hibagus/64pointFFTProcessor/Verification/UVM/sim/README

LAB 3 - Universal Verification Methodology

make all : To run the given uvm_test, which generates 100 input sequences randomly and applies them to the DUT. This does not fire the GUI.

make gui : Fires the same test as above, however alongside the GUI

make clean : Removes the work directory and the transcript
