hibagus/64pointFFTProcessor/Report/EE382M_Verification_for_Digital_System/EE382M_Verification_Project_Report.pdf

Bagus Hanindhito (bh29293), Tosin Jemilehin (tej474), Ashen Ekanayake (ese396) The University of Texas at Austin

MAY 2020

# Verification of 64 Point FFT/IFFT Processor

EE 382M-11 Verification of Digital Systems

- Introduction
- Formal Verification
- Universal Verification Methodology
- Logical Equivalence Checking
- Conclusion

### Agenda

# Introduction

### Basic Operation

- The circuit decomposes 64-point FFT/IFFT into two-dimensional 8-point FFT/IFFT.
– A s + 8t = σl=0
7 W64
sl σm=0
7 | B(l + 8m)W8
sm | W8

lt
– W8
sm and W8

lt are 8-point twiddle-factors (complex constant) – W64
sl is 64-point twiddle-factors (complex constant)
- No true multiplier; Multiplication is implemented as shift-and-add.

### Data Format

- The circuit uses Q4.12 Signed Fixed-Point format for both real data and imaginary data to form 32-bit complex data. – Largest value is 7.9997558593750 (0b0111111111111111)
– Smallest value is -8.0000000000000 (0b1000000000000000) – Resolution is 0.0002441406250 (0b0000000000000001)

Complex Data Set (32-bit)

31...16 Real Data (16-bit) 15...0 Imaginary Data (16-bit)

### Block Diagram

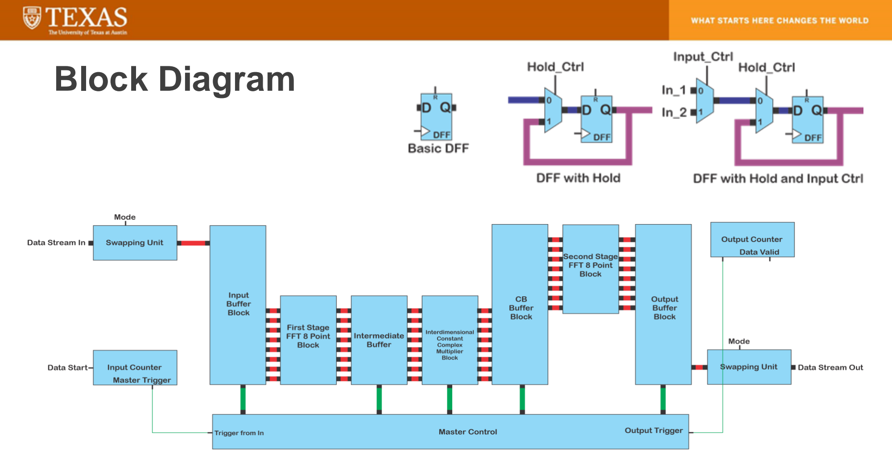
[picture p5: page 6]

### Circuit Behavior

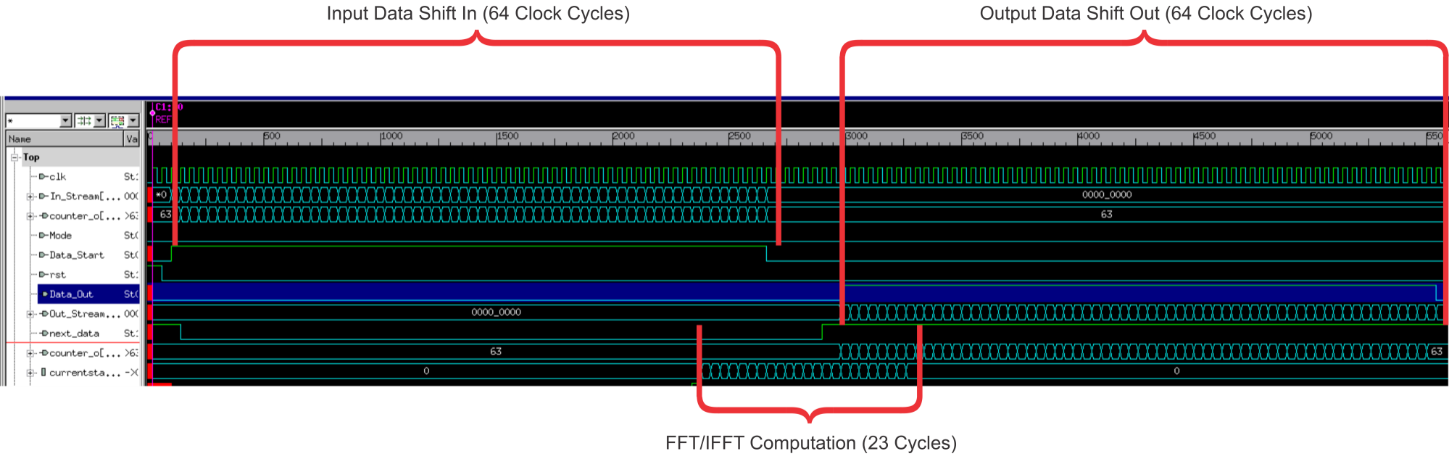
[picture p6: figure]

- Single FFT/IFFT operation can be completed in 135 Cycles

### Verification Plan

- Formal Verification
– To verify the Master Control block (RTL-Level)
- Universal Verification Methodology (UVM) – To verify full-circuit functionality (RTL-Level)
- Logical Equivalence Checking (LEC)
– To verify synthesized netlist against RTL model
– To verify implementation against the generated netlist

# Formal Verification

### Overview

- Formal Verification using Cadence JasperGold.
- Verification is done for Master Control block.
– The heart of the circuit.
– Control the dataflow and operation throughout the circuit.
– Need to be verified extensively.
- Properties are written based on the specification of the circuits.

### Assumption

- Master control is triggered by Input Counter when the 56th input data enters the Input Buffer.
– Mastertrig signal goes high at least one clock cycle.
- Master control consists of 23 states
– 23 clock cycles to perform FFT/IFFT computation – No interruption is possible after triggered.
– Full cycle starts at IDLE state, end at IDLE state. – Cannot be triggered before the full cycle is ended.

### Input Data Set

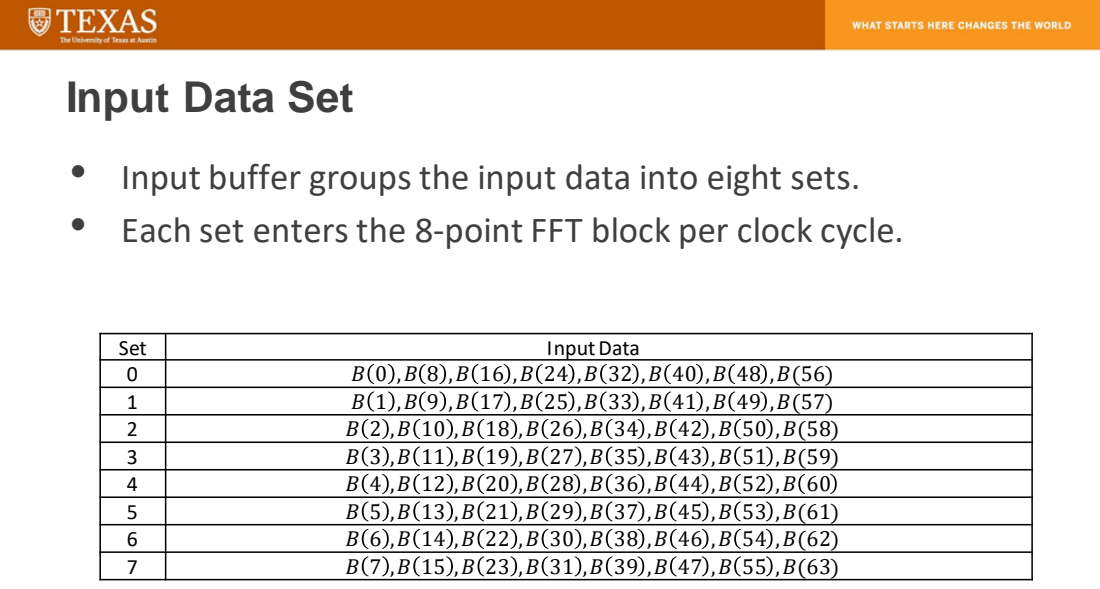
[picture p7: page 12]

• Input buffer groups the input data into eight sets.
• Each set enters the 8-point FFT block per clock cycle.

Set | Input Data
0 | B 0 ,B 8 ,B 16 ,B 24 ,B 32 ,B 40 ,B 48 ,B(56)
1 | B 1 ,B 9 ,B 17 ,B 25 ,B 33 ,B 41 ,B 49 ,B(57)
2 | B 2 ,B 10 ,B 18 ,B 26 ,B 34 ,B 42 ,B 50 ,B(58)
3 | B 3 ,B 11 ,B 19 ,B 27 ,B 35 ,B 43 ,B 51 ,B(59)
4 | B 4 ,B 12 ,B 20 ,B 28 ,B 36 ,B 44 ,B 52 ,B 60
5 | B 5 ,B 13 ,B 21 ,B 29 ,B 37 ,B 45 ,B 53 ,B(61)
6 | B 6 ,B 14 ,B 22 ,B 30 ,B 38 ,B 46 ,B 54 ,B(62)
7 | B 7 ,B 15 ,B 23 ,B 31 ,B 39 ,B 47 ,B 55 ,B(63)

### Complex Constant Multiplier Scheduling

- This specification governs how the master control block behaves. (Red = Multi-Cycle Multiplication)
SET | DATA0 | DATA1 | DATA2 | DATA3 | DATA4 | DATA5 | DATA6 | DATA7
CONST | TYPE | CONST | TYPE | CONST | TYPE | CONST | TYPE | CONST | TYPE | CONST | TYPE | CONST | TYPE | CONST | TYPE
SET 0 | BYPASS | 1 | BYPASS | 1 | BYPASS | 1 | BYPASS | 1 | BYPASS | 1 | BYPASS | 1 | BYPASS | 1 | BYPASS | 1
SET 1 | BYPASS | 1 | 1 | 1 | 2 | 1 | 3 | 1 | 4 | 1 | 5 | 1 | 6 | 1 | 7 | 1
SET 2 | BYPASS | 1 | 2 | 1 | 4 | 1 | 6 | 1 | 8 | 1 | HOLD | HL | HOLD | | HOLD | HL
| HOLD | 1 | HOLD | HL | HOLD | HL | HOLD | HL | HOLD | HL | 6 | 5 | 4 | 5 | 2 | 5
SET 3 | BYPASS | 1 | 3 | 1 | 6 | 1 | 7 | 5 | 4 | 5 | 1 | 5 | 2 | 7 | 5 | 7
SET 4 | BYPASS | 1 | 4 | 1 | 8 | 1 | HOLD | HL | BYPASS | 5 | HOLD | HL | HOLD | HL | HOLD | HL
| HOLD | HL | HOLD | HL | HOLD | HL | 4 | 5 | HOLD | HL | HOLD | HL | HOLD | HL | HOLD | HL
| HOLD | HL | HOLD | HL | HOLD | HL | HOLD | HL | HOLD | HL | 4 | 7 | 8 | 7 | HOLD | HL
| HOLD | HL | HOLD | HL | HOLD | HL | HOLD | HL | HOLD | HL | HOLD | HL | HOLD | HL | 4 | 3
SET 5 | BYPASS | 1 | 5 | 1 | 6 | 5 | 1 | 5 | 4 | 7 | 7 | 3 | 2 | 3 | 3 | 2
SET 6 | BYPASS | 1 | 6 | 1 | 4 | 5 | 2 | 7 | 8 | 7 | HOLD | HL | HOLD | HL | HOLD | HL
| HOLD | HL | HOLD | HL | HOLD | HL | HOLD | HL | HOLD | HL | 2 | 3 | 4 | 2 | 6 | 6
SET 7 | BYPASS | 1 | 7 | 1 | 2 | 5 | 5 | 7 | 4 | 3 | 3 | 2 | 6 | 6 | 1 | 4

### Input Buffer Control Signal

- hold_all_in

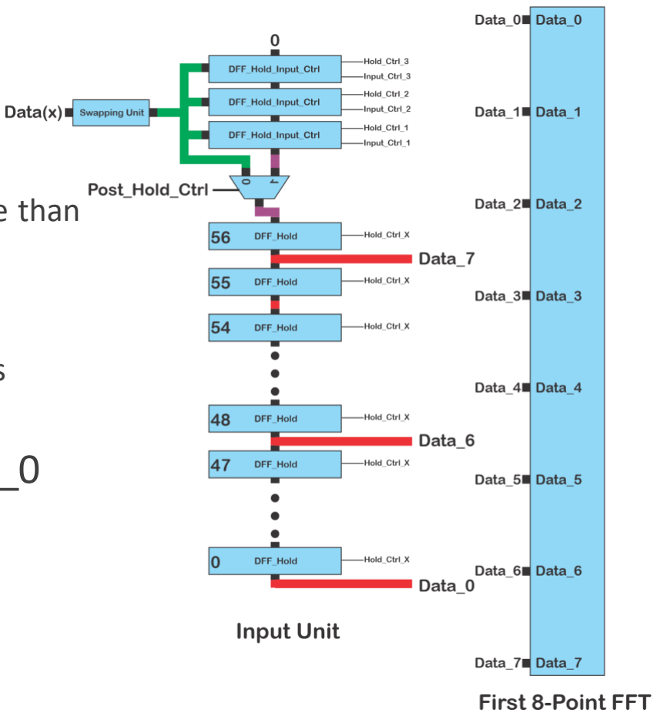
[picture p8: figure]

– Stall input circuit when multiplier needs more than 1 cycle
- hold_buf_2, hold_buf_1, hold_buf_0

– Stall additional buffers when multiplier needs more than 1 cycle.
- in_ctrl_buf_2, in_ctrl_buf_1, in_ctrl_buf_0

– Select the input of additional buffers.
- pos_hold_ctrl

– Select the input of main buffer segment.

### Input Buffer Control Signal Assertion

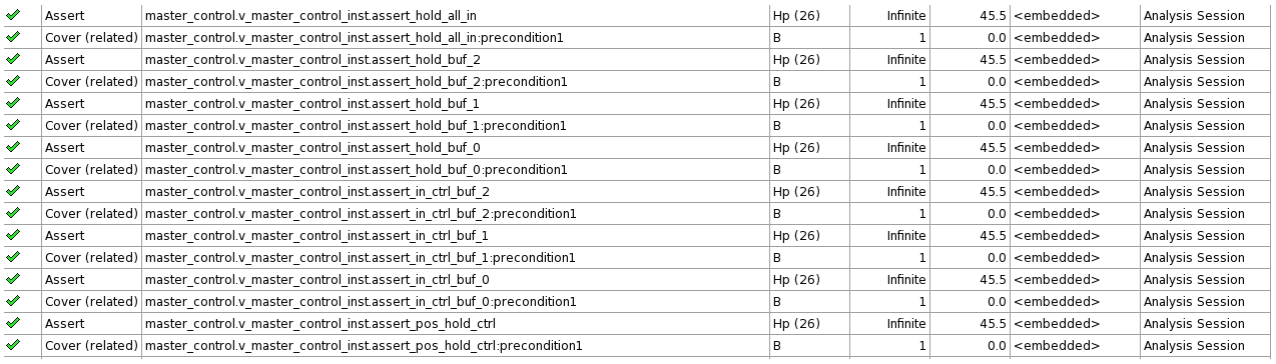
[picture p9: figure]

### Complex Constant Multiplier Unit

- Eight complex constant multiplier blocks, one for each type.
Type | Input Operand | Pre-Processing | Constant Operand | Result | Post Processing
1 | A + jB | NONE A + jB | C + jD | AC − BD + j(AD + BC) | NONE AC − BD + j(AD + BC)
2 | A + jB | IM_INVERT A − jB | C + jD | AC + BD + j(AD − BC) | IM_INVERT AC + BD + j(−AD + BC)
3 | A + jB | RE_INVERT −A + jB | C + jD | −AC − BD + j(−AD + BC) | IM_INVERT −AC − BD + j(AD − BC)
4 | A + jB | RE_INVERT IM_INVERT −A − jB | C + jD | −AC + BD + j(−AD − BC) | NONE −AC + BD + j(−AD − BC)
5 | A + jB | RE-IM SWAP B + jA | C + jD | −AD + BC + j(AC + BD) | RE_INVERT AD − BC + j(AC + BD)
6 | A + jB | RE-IM SWAP IM_INVERT B − jA | C + jD | AD + BC + j(−AC + BD) | NONE AD + BC + j(−AC + BD)
7 | A + jB | RE-IM SWAP RE_INVERT −B + jA | C + jD | −AD − BC + j(AC − BD) | NONE −AD − BC + j(AC − BD)
8 | A + jB | RE-IM SWAP RE_INVERT IM_INVERT −B − jA | C + jD | AD − BC + j(−AC − BD) | RE_INVERT −AD + BC + j(−AC − BD)

### Complex Constant Multiplier Unit (cont’d)

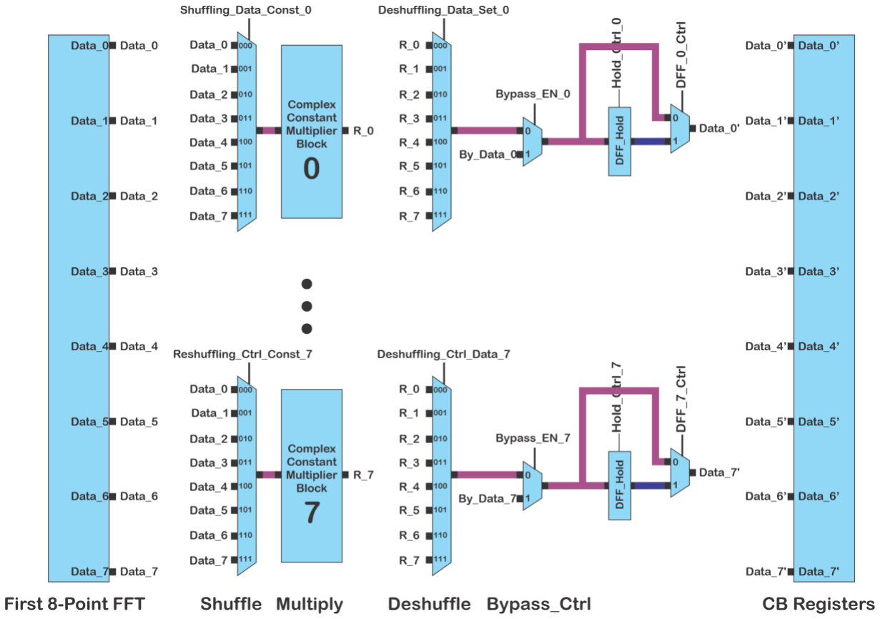
[picture p10: figure]

### Complex Const. Mult.: Shuffle Unit

- Shuf_Ctrl_0 through Shuf_Ctrl_7

– Select which set of data goes which constant multiplier.

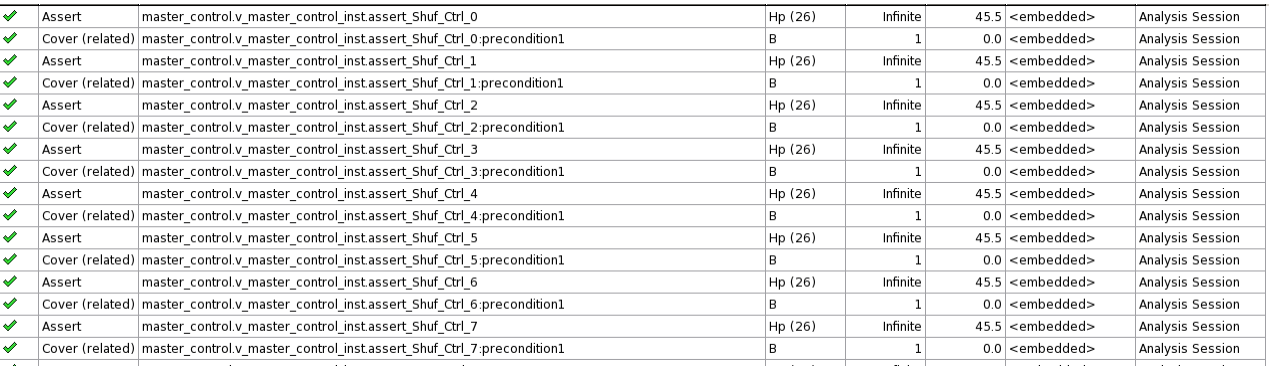
[picture p11: figure]

### Complex Const. Mult.: Multiplier Unit

- Type_Sel_0 through Type_Sel_7

– Select the type of operation that each multiplier does.

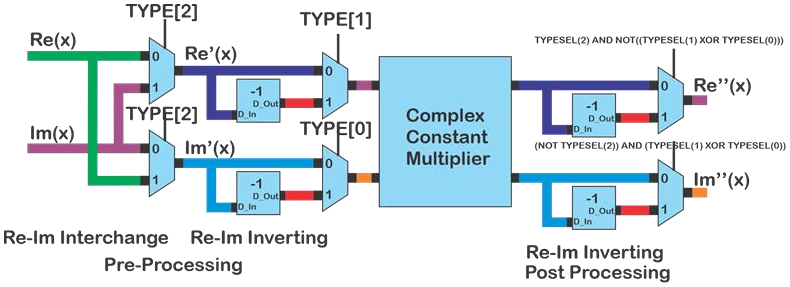
[picture p12: figure]

### Complex Const. Mult.: Multiplier Unit Assertion

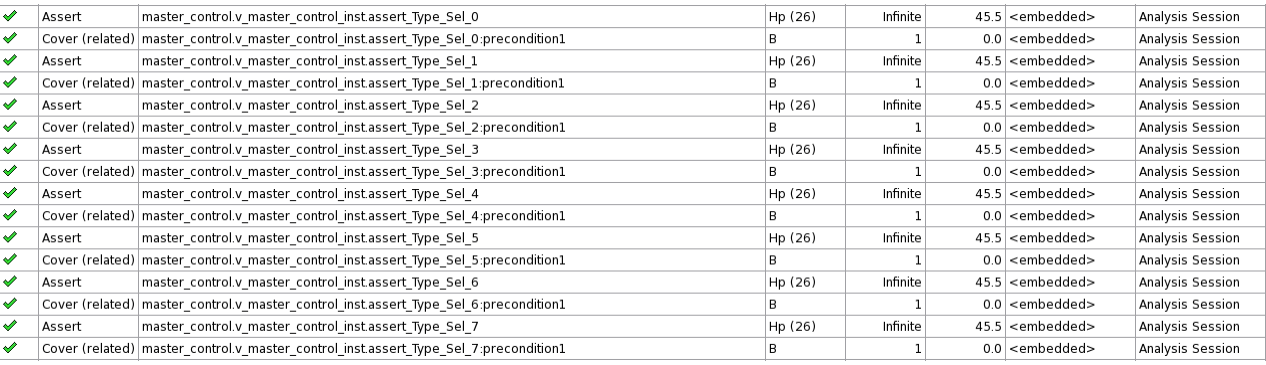
[picture p13: figure]

### Complex Const. Mult.: Bypass Unit

- Bypass_Sel_0 through Bypass_Sel_7

– Select whether a multiplication is performed or not for each multiplication block. Bypass means no multiplication (only swapping or sign inverting the real and imaginary parts).

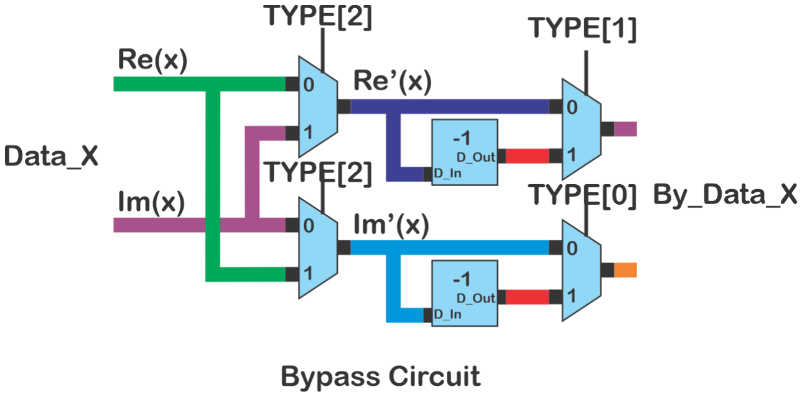
[picture p14: figure]

### Complex Const. Mult.: Bypass Unit Assertion

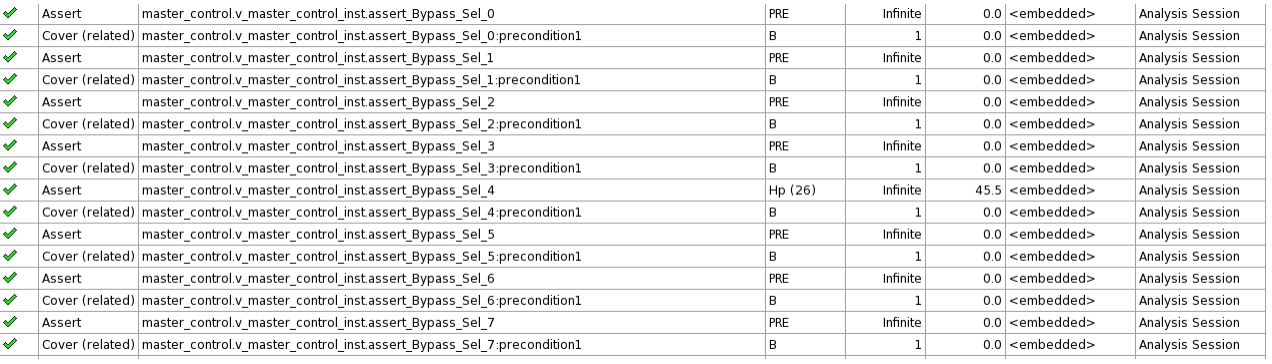
[picture p15: figure]

### Complex Const. Mult.: Deshuffle Unit

- DeShuf_Ctrl_0 through DeShuf_Ctrl_7

– Select return path of the dataset after being multiplied.

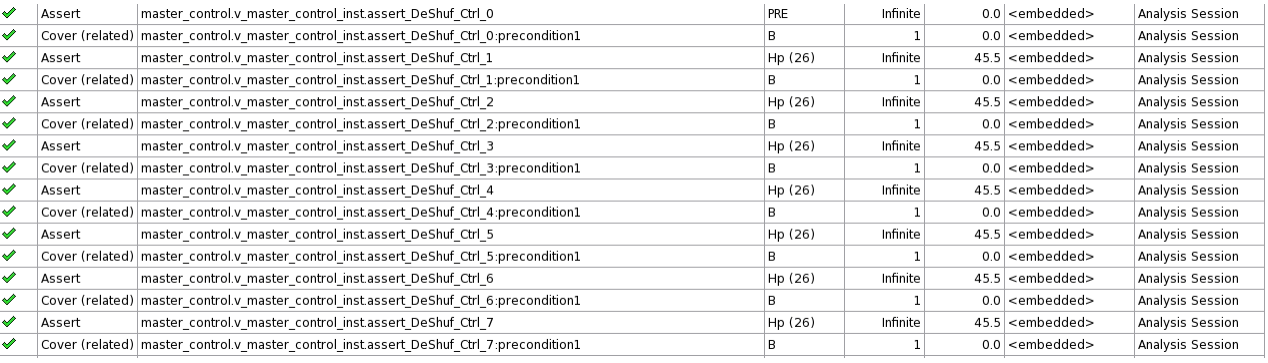
[picture p16: figure]

### Complex Const. Mult.: Datapath Unit

- Bypass_EN_0 through Bypass_EN_7

– Select whether to use dataset from multiplier unit or from bypass unit.
- Hold_Ctrl_0 through Hold_Ctrl_7

– Select whether to stall the datapath due to multicycle multiplication.
- DFF_Ctrl_0 through DFF_Ctrl_7

– Select whether to use next data or delayed data.

### Complex Const. Mult.: Datapath Unit (Assertion)

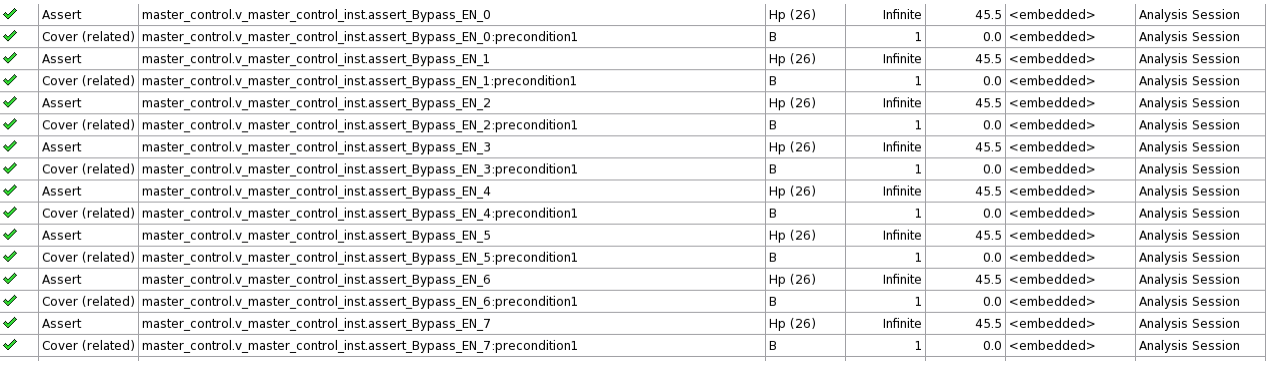
[picture p17: figure]

### Complex Const. Mult.: Datapath Unit (Assertion)

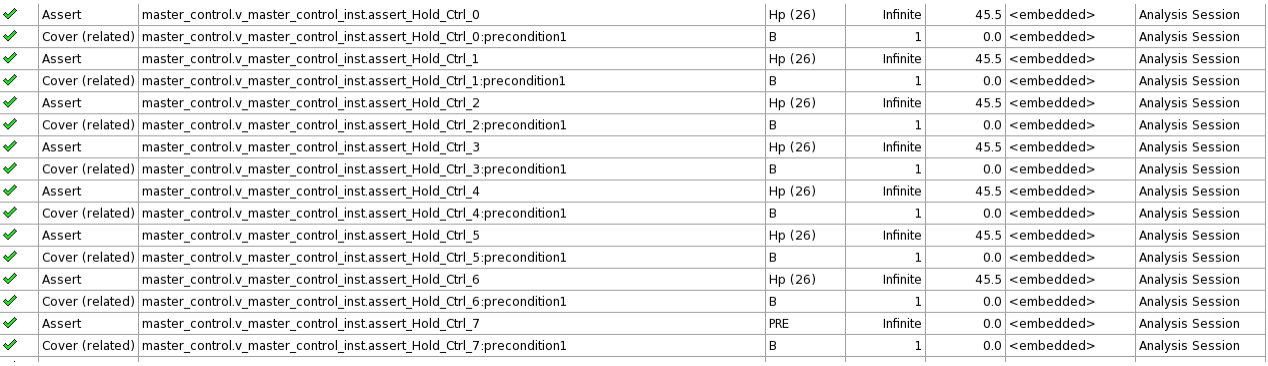
[picture p18: figure]

### Complex Const. Mult.: Datapath Unit (Assertion)

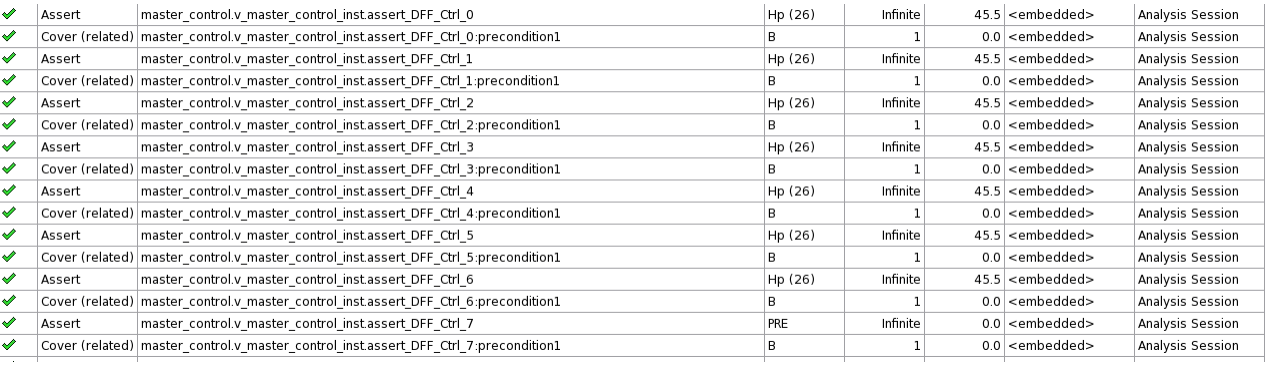
[picture p19: figure]

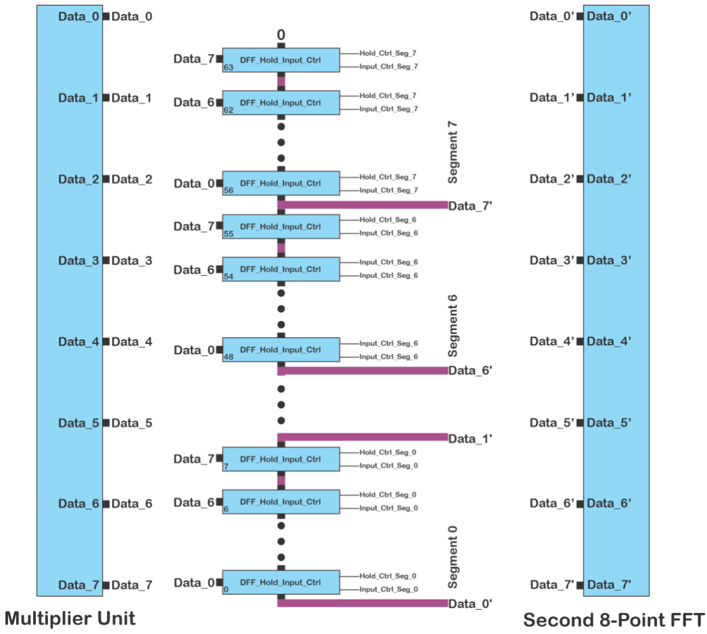
[picture p20: figure]

### Compute Buffer (CB)

- Rearrange Dataset for second stage of 8-point FFT.
- hold_seg_0 through hold_seg_7

– To stall each segment of the buffer
- input_ctrl_all_cb

– To select which data to buffer.

### Compute Buffer (CB) (Assertion)

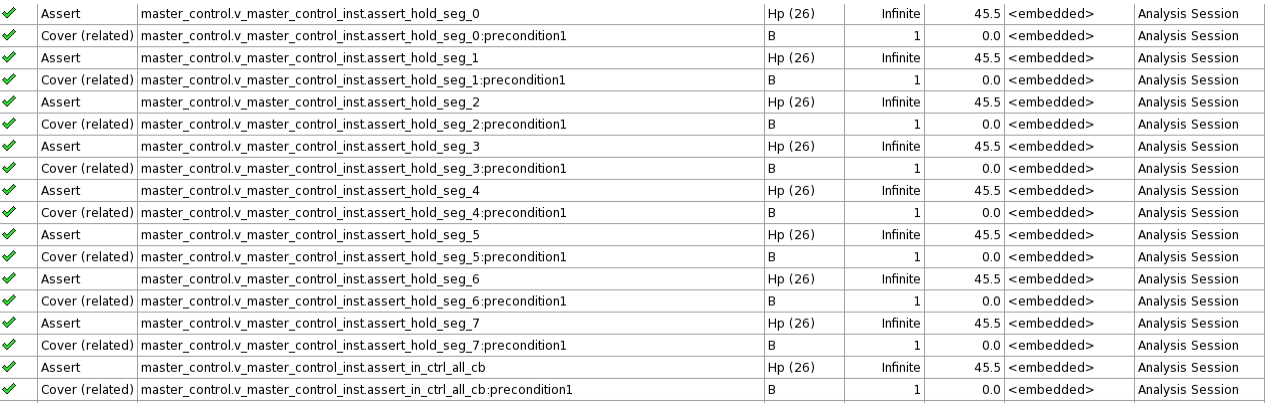
[picture p21: figure]

### Output Buffer

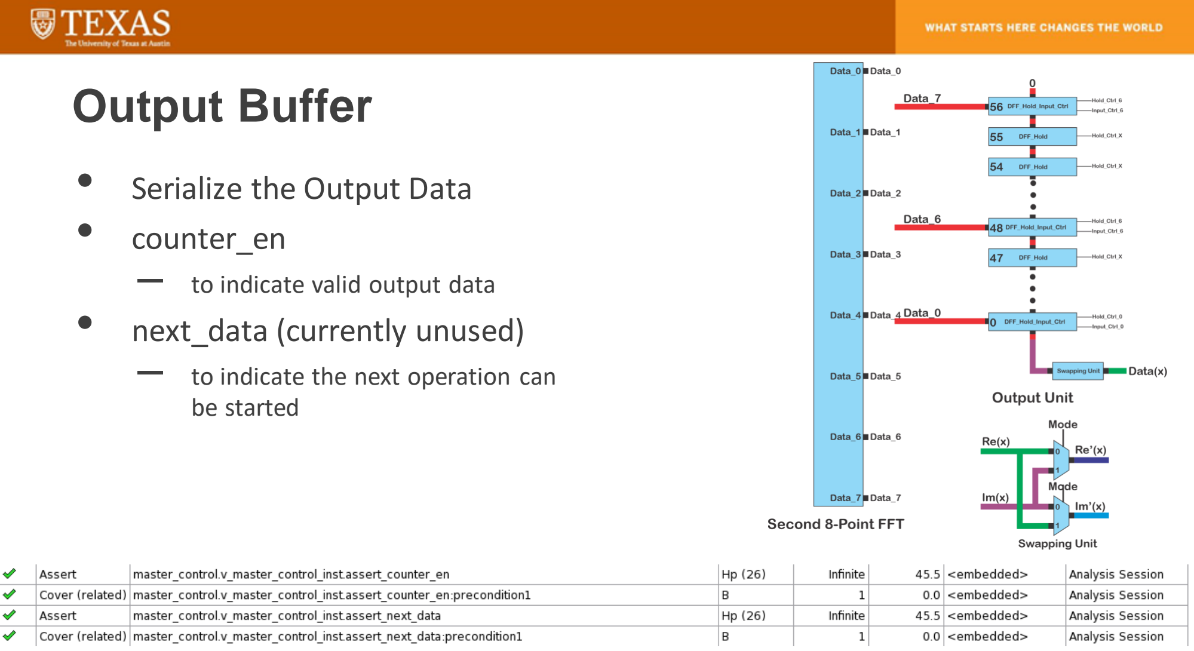
[picture p22: page 30]

- Serialize the Output Data
- counter_en

– to indicate valid output data
- next_data (currently unused)

– to indicate the next operation can be started

# Universal Verification Methodology (UVM)

- Step 1: Understanding the Interface

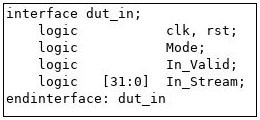
[picture p23: figure]

- Step 2: Create a dummy (DUT) module to setup the UVM environment

Mimic the basic behavior without worrying about the exact functionality

(Using the same input output interfaces)

### UVM Verification Steps

- Step 3: Modify the Scoreboard
- Difficult
– 16-bit Fixed Point
– No SV Support

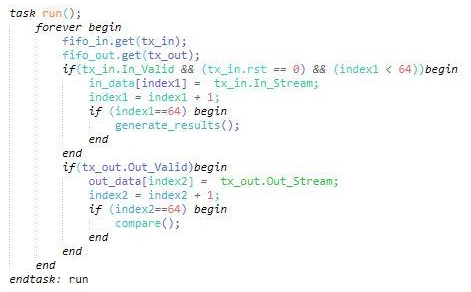
[picture p24: figure]

- Solution
– Connect FFT and
IFFT together as
the DUT
- Alternative Solution
– DPI-C
- Step 4: Write a Perfect FFT

### UVM Verification Steps (cont’d)

FFT | IFFT

Time Domain
Data In

Time Domain
Data Out

Frequency
Domain Data

Theoretically,
Time Domain Data In = Time Domain Data Out

However there might be small errors due to rounding off in fixed point arithmetic

### UVM Verification Steps (cont’d)

- Step 5: Generating the sequences

– Reset sequences (created a new sequence class)
– Usual input data sequence with necessary constraints

(- 0.10009765625 < Data < 0.10009765625)

– Generate enough sequences to get an output

### UVM Verification Steps (cont’d)

- Step 6: Simulating Using “ModelSim”

### UVM Verification Steps (cont’d)

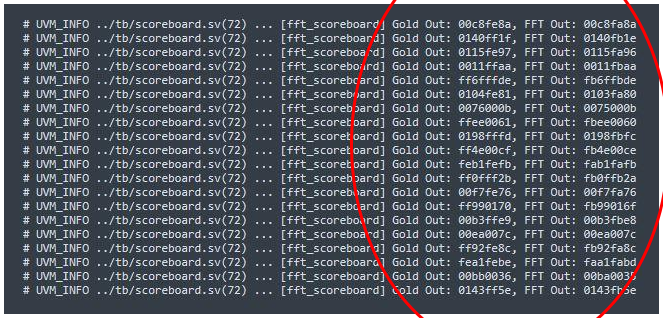
[picture p25: figure]

# Logical Equivalence Checking

Motivation
- To ensure logical equivalence doesn't break along chip design process
- To ensure design intent is retained as design move into real life implementation

### Logical Equivalence Checking

### Stages considered

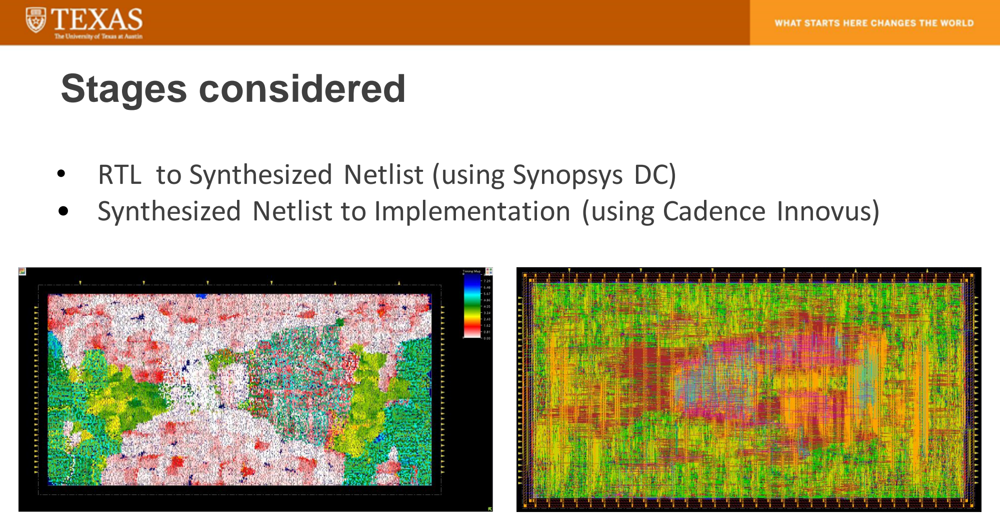
[picture p26: page 39]

- RTL to Synthesized Netlist (using Synopsys DC)
- Synthesized Netlist to Implementation (using Cadence Innovus)

- Setup
– Identifying keypoints/cuts
- Mapping
– Mapping keypoints
- Comparison

First stage
- RTL ---> Synthesized Netlist

### LEC Workflow

- Setup
– Golden -> RTL
– Revised -> Generated Netlist
- Assumption
– Sequential constant set to 0 – Sequential merge to reduce unreachable states

### RTL to Synthesized Netlist

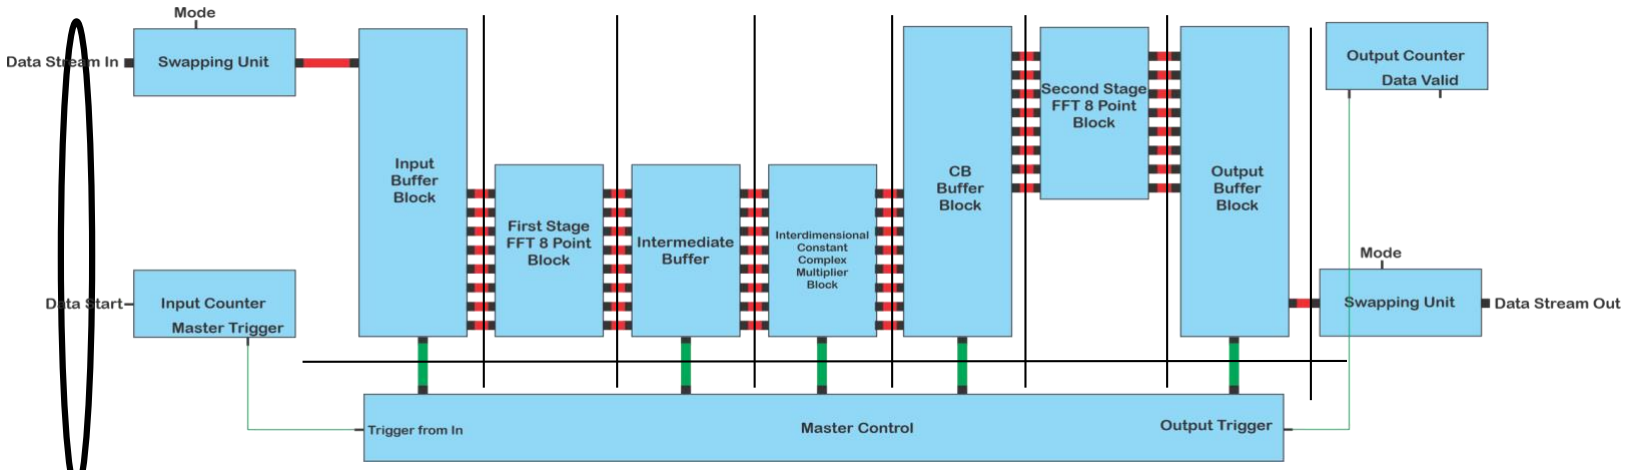
[picture p27: figure]

### RTL to Synthesized Netlist(Mapping)

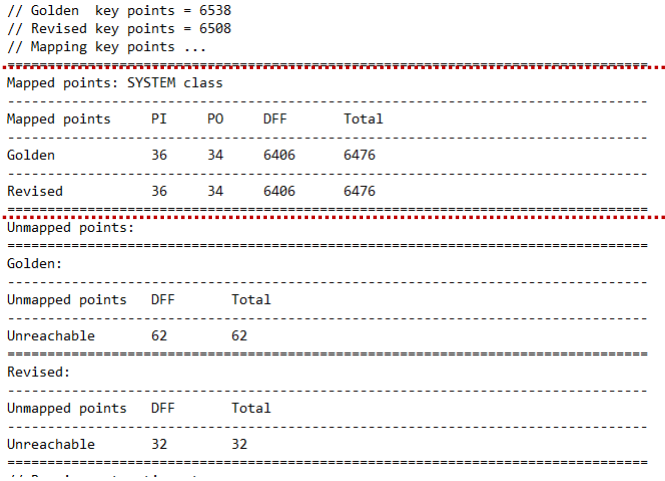
[picture p28: figure]

### RTL to Synthesized Netlist(Mapping)

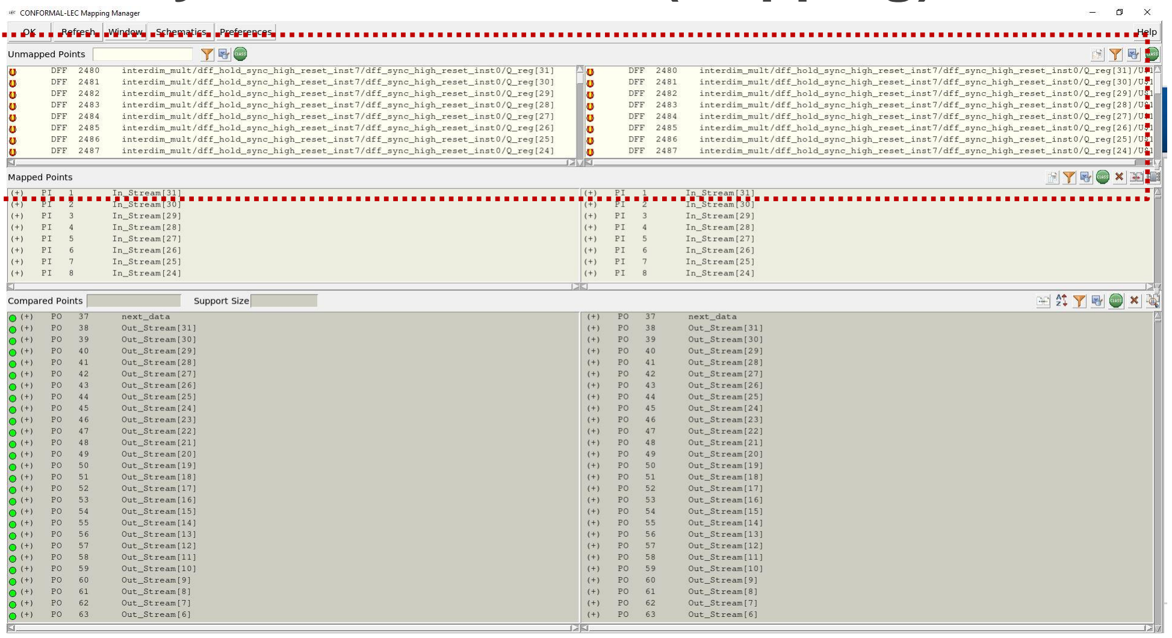
[picture p29: figure]

Mapping manager

### RTL to Synthesized Netlist(Comparison)

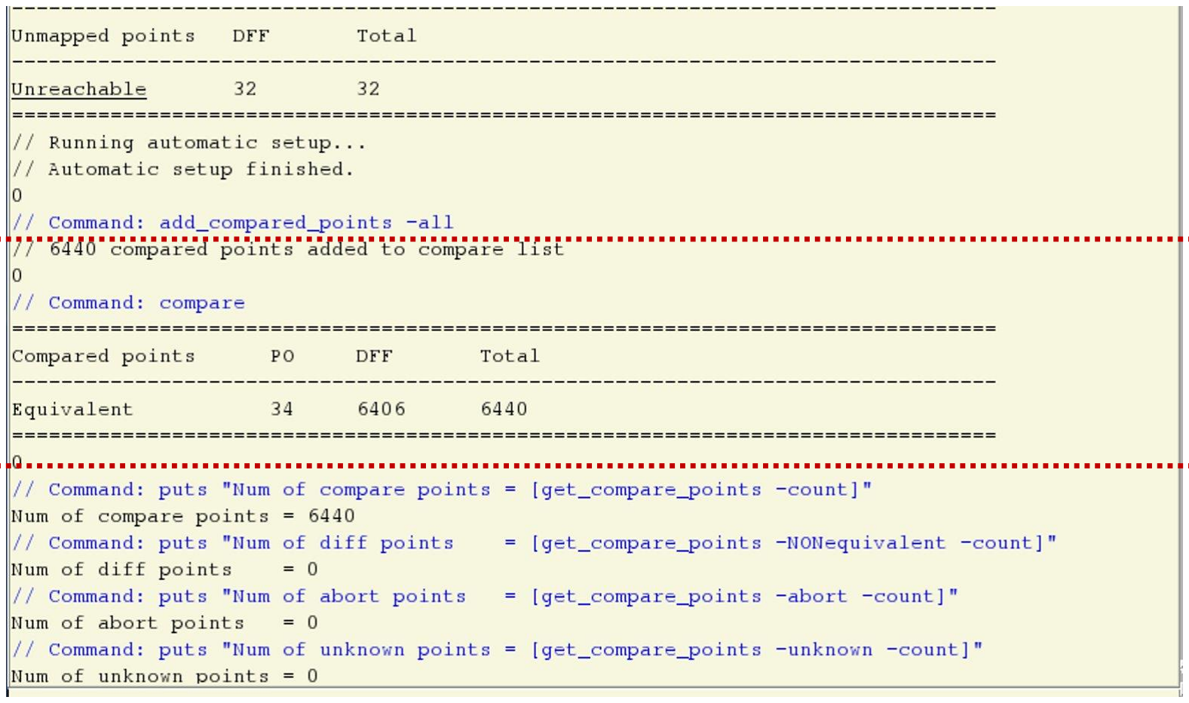
[picture p30: figure]

- Setup
– Golden -> Verified Netlist
– Revised -> Implementation Design
- Assumption

– Sequential constant set to 0
– Sequential merge to reduce unreachable

states
– Black boxes were defined due to

insufficient library definitions

### Netlist to Implementation Stage

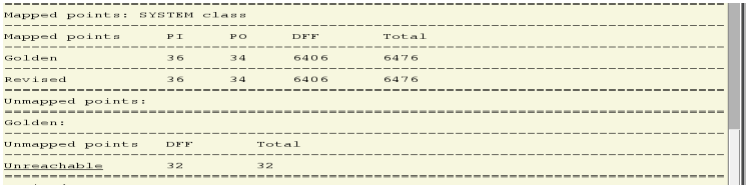
[picture p31: figure]

Mapping

### Netlist to Implementation(Mapping)

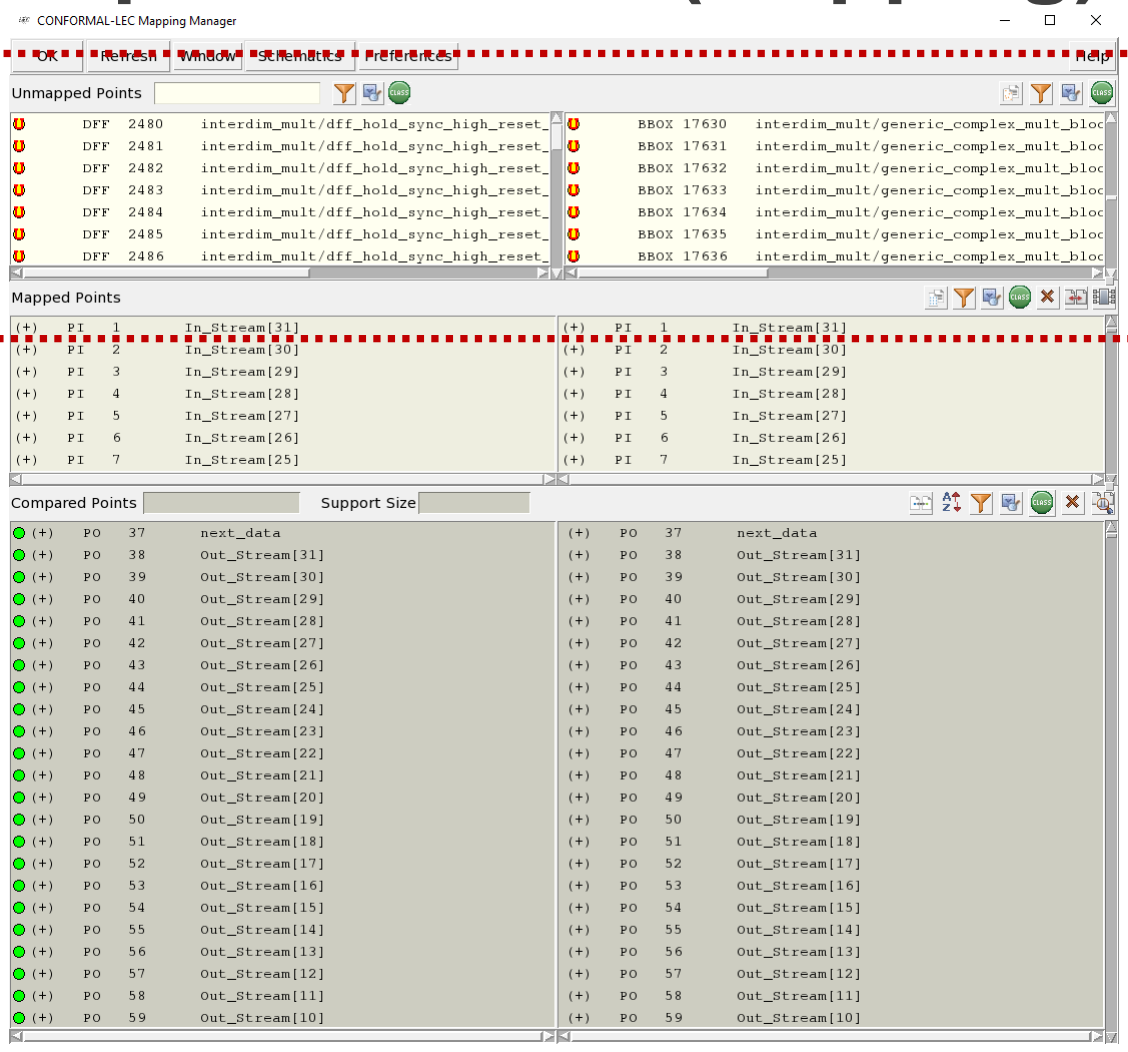
[picture p32: figure]

### RTL to Synthesized Netlist(Comparison)

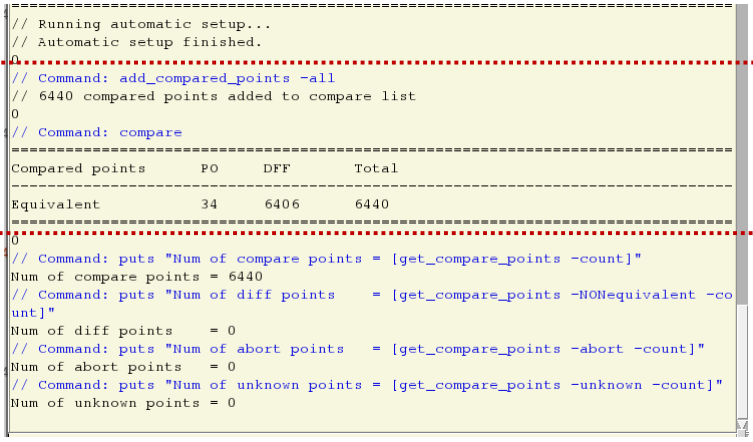
[picture p33: figure]

# Conclusion

- We were able to complete a comprehensive verification on the FFT/IFFT Processor
- Formal Verification was carried out on the “Master Control” unit
- RTL design was tested using UVM
- Gate level and implementation level netlists were verified using Logical Equivalence Checking
- Our project is available on GitHub to anyone for further experiments

https://github.com/ashanuka/FFT-IFFT-Verification

### Conclusion

- Maharatna, Koushik, Grass, Eckhard and Jagdhold, Ulrich (2004) A 64-point Fourier transform chip for high-speed wireless LAN application using OFDM. IEEE Journal of Solid-State Circuit, 39 (3), 484-493.

### Reference
