hibagus/64pointFFTProcessor/Verification/LEC/Mapping manager(netlist_implementation).JPG

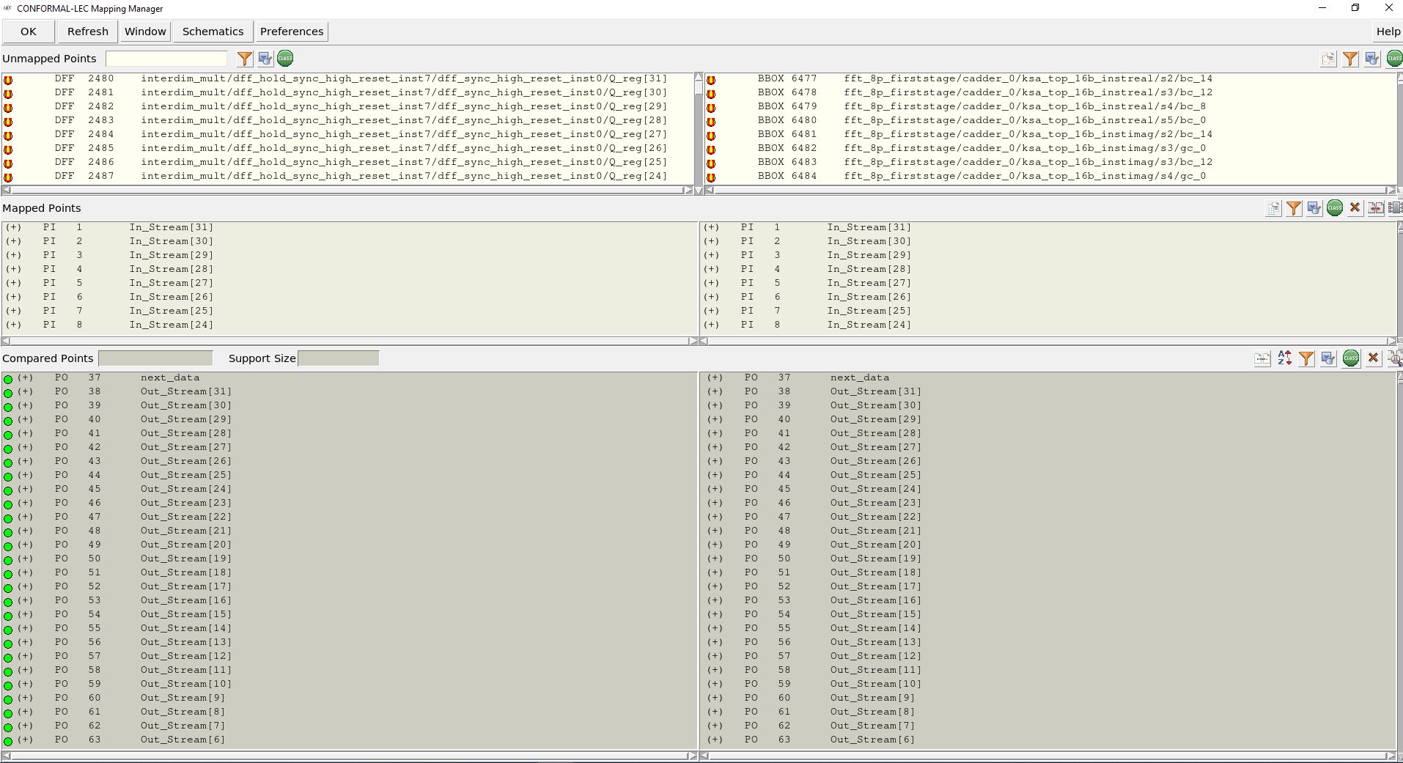
Verification/LEC/Mapping manager(netlist_implementation).JPG
