hibagus/64pointFFTProcessor/Verification/LEC/summary(netlist_implementation).JPG

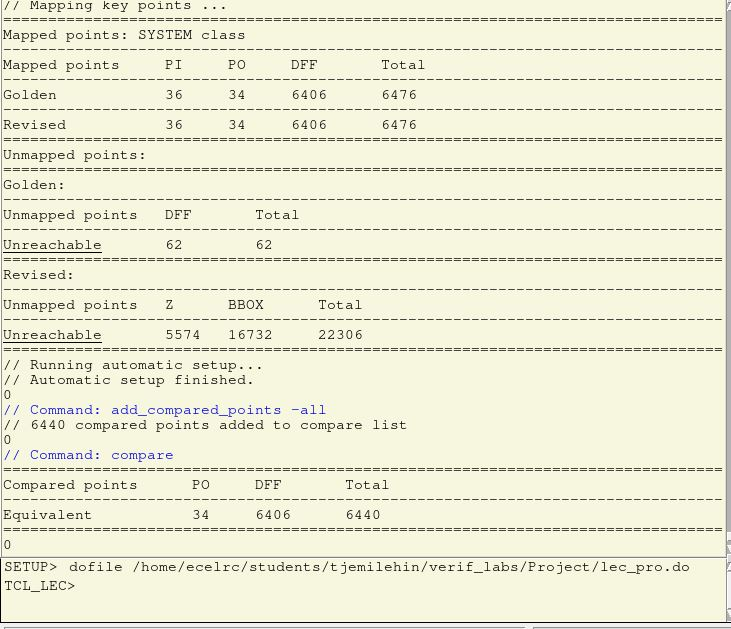
Verification/LEC/summary(netlist_implementation).JPG
