hibagus/64pointFFTProcessor/Verification/LEC/summary(rtl_netlist).JPG

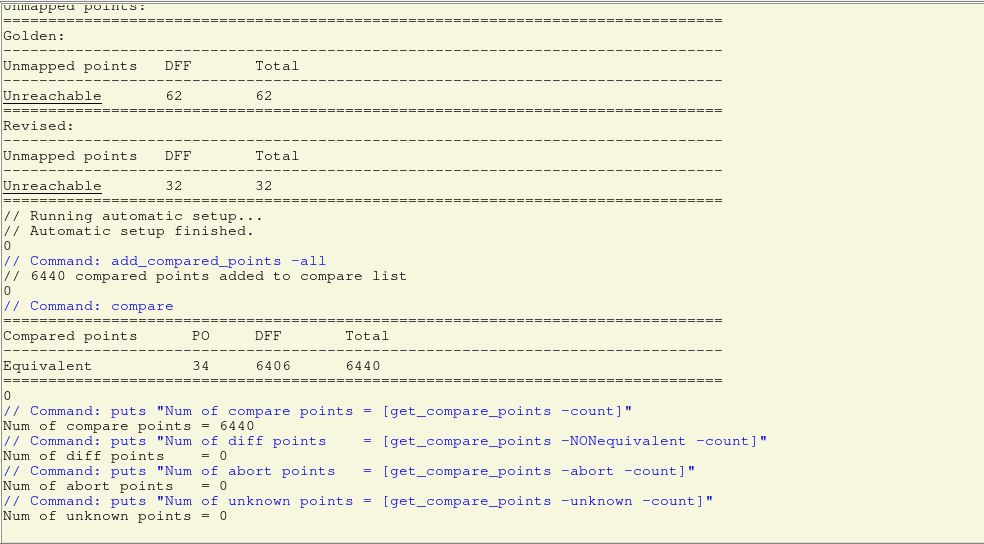
Verification/LEC/summary(rtl_netlist).JPG
