hibagus/64pointFFTProcessor/Verification/Formal/v_master_control.sv

module v_master_control (
    clk,
    rst,
    mastertrig,
    hold_all_in,
    hold_buf_2,
    hold_buf_1,
    hold_buf_0,
    in_ctrl_buf_2,
    in_ctrl_buf_1,
    in_ctrl_buf_0,
    pos_hold_ctrl,
    Shuf_Ctrl_0,
    Shuf_Ctrl_1,
    Shuf_Ctrl_2,
    Shuf_Ctrl_3,
    Shuf_Ctrl_4,
    Shuf_Ctrl_5,
    Shuf_Ctrl_6,
    Shuf_Ctrl_7,
    Type_Sel_0,
    Type_Sel_1,
    Type_Sel_2,
    Type_Sel_3,
    Type_Sel_4,
    Type_Sel_5,
    Type_Sel_6,
    Type_Sel_7,
    Bypass_Sel_0,
    Bypass_Sel_1,
    Bypass_Sel_2,
    Bypass_Sel_3,
    Bypass_Sel_4,
    Bypass_Sel_5,
    Bypass_Sel_6,
    Bypass_Sel_7,
    DeShuf_Ctrl_0,
    DeShuf_Ctrl_1,
    DeShuf_Ctrl_2,
    DeShuf_Ctrl_3,
    DeShuf_Ctrl_4,
    DeShuf_Ctrl_5,
    DeShuf_Ctrl_6,
    DeShuf_Ctrl_7,
    Bypass_EN_0,
    Bypass_EN_1,
    Bypass_EN_2,
    Bypass_EN_3,
    Bypass_EN_4,
    Bypass_EN_5,
    Bypass_EN_6,
    Bypass_EN_7,
    Hold_Ctrl_0,
    Hold_Ctrl_1,
    Hold_Ctrl_2,
    Hold_Ctrl_3,
    Hold_Ctrl_4,
    Hold_Ctrl_5,
    Hold_Ctrl_6,
    Hold_Ctrl_7,
    DFF_Ctrl_0,
    DFF_Ctrl_1,
    DFF_Ctrl_2,
    DFF_Ctrl_3,
    DFF_Ctrl_4,
    DFF_Ctrl_5,
    DFF_Ctrl_6,
    DFF_Ctrl_7,
    hold_seg_0,
    hold_seg_1,
    hold_seg_2,
    hold_seg_3,
    hold_seg_4,
    hold_seg_5,
    hold_seg_6,
    hold_seg_7,
    in_ctrl_all_cb,
    counter_en,
    next_data
    );


  input                   clk;
  input                   rst;
  input                   mastertrig;
  input                   hold_all_in;
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
        .hold_seg_3(hold_seg_3),
        .hold_seg_4(hold_seg_4),
        .hold_seg_5(hold_seg_5),
        .hold_seg_6(hold_seg_6),
        .hold_seg_7(hold_seg_7),
        .in_ctrl_all_cb(in_ctrl_all_cb),
        .counter_en(counter_en),
        .next_data(next_data)
    );
endmodule
