hibagus/64pointFFTProcessor/VHDL/master_control.vhd

LIBRARY ieee;
USE ieee.std_logic_1164.all;
USE ieee.numeric_std.all;
USE ieee.std_logic_unsigned.all;

ENTITY master_control IS
	PORT	(
				clk		         : IN  STD_LOGIC;
			    rst		         : IN  STD_LOGIC;
				mastertrig		 : IN  STD_LOGIC;
                hold_all_in      : OUT STD_LOGIC;
                hold_buf_3       : OUT STD_LOGIC;
                hold_buf_2       : OUT STD_LOGIC;
                hold_buf_1       : OUT STD_LOGIC;
                in_ctrl_buf_3    : OUT STD_LOGIC;
                in_ctrl_buf_2    : OUT STD_LOGIC;
                in_ctrl_buf_1    : OUT STD_LOGIC;
                pos_hold_ctrl    : OUT STD_LOGIC;
                Shuf_Ctrl_1      : OUT STD_LOGIC_VECTOR(2 DOWNTO 0);
                Shuf_Ctrl_2      : OUT STD_LOGIC_VECTOR(2 DOWNTO 0);
                Shuf_Ctrl_3      : OUT STD_LOGIC_VECTOR(2 DOWNTO 0);
                Shuf_Ctrl_4      : OUT STD_LOGIC_VECTOR(2 DOWNTO 0);
                Shuf_Ctrl_5      : OUT STD_LOGIC_VECTOR(2 DOWNTO 0);
                Shuf_Ctrl_6      : OUT STD_LOGIC_VECTOR(2 DOWNTO 0);
                Shuf_Ctrl_7      : OUT STD_LOGIC_VECTOR(2 DOWNTO 0);
                Shuf_Ctrl_8      : OUT STD_LOGIC_VECTOR(2 DOWNTO 0);
                Type_Sel_1       : OUT STD_LOGIC_VECTOR(2 DOWNTO 0);
                Type_Sel_2       : OUT STD_LOGIC_VECTOR(2 DOWNTO 0);
                Type_Sel_3       : OUT STD_LOGIC_VECTOR(2 DOWNTO 0);
                Type_Sel_4       : OUT STD_LOGIC_VECTOR(2 DOWNTO 0);
                Type_Sel_5       : OUT STD_LOGIC_VECTOR(2 DOWNTO 0);
                Type_Sel_6       : OUT STD_LOGIC_VECTOR(2 DOWNTO 0);
                Type_Sel_7       : OUT STD_LOGIC_VECTOR(2 DOWNTO 0);
                Type_Sel_8       : OUT STD_LOGIC_VECTOR(2 DOWNTO 0);
                Bypass_Sel_0     : OUT STD_LOGIC_VECTOR(2 DOWNTO 0);
                Bypass_Sel_1     : OUT STD_LOGIC_VECTOR(2 DOWNTO 0);
                Bypass_Sel_2     : OUT STD_LOGIC_VECTOR(2 DOWNTO 0);
                Bypass_Sel_3     : OUT STD_LOGIC_VECTOR(2 DOWNTO 0);
                Bypass_Sel_4     : OUT STD_LOGIC_VECTOR(2 DOWNTO 0);
                Bypass_Sel_5     : OUT STD_LOGIC_VECTOR(2 DOWNTO 0);
                Bypass_Sel_6     : OUT STD_LOGIC_VECTOR(2 DOWNTO 0);
                Bypass_Sel_7     : OUT STD_LOGIC_VECTOR(2 DOWNTO 0);
                DeShuf_Ctrl_0    : OUT STD_LOGIC_VECTOR(2 DOWNTO 0);
                DeShuf_Ctrl_1    : OUT STD_LOGIC_VECTOR(2 DOWNTO 0);
                DeShuf_Ctrl_2    : OUT STD_LOGIC_VECTOR(2 DOWNTO 0);
                DeShuf_Ctrl_3    : OUT STD_LOGIC_VECTOR(2 DOWNTO 0);
                DeShuf_Ctrl_4    : OUT STD_LOGIC_VECTOR(2 DOWNTO 0);
                DeShuf_Ctrl_5    : OUT STD_LOGIC_VECTOR(2 DOWNTO 0);
                DeShuf_Ctrl_6    : OUT STD_LOGIC_VECTOR(2 DOWNTO 0);
                DeShuf_Ctrl_7    : OUT STD_LOGIC_VECTOR(2 DOWNTO 0);
                Bypass_EN_0      : OUT STD_LOGIC;
                Bypass_EN_1      : OUT STD_LOGIC;
                Bypass_EN_2      : OUT STD_LOGIC;
                Bypass_EN_3      : OUT STD_LOGIC;
                Bypass_EN_4      : OUT STD_LOGIC;
                Bypass_EN_5      : OUT STD_LOGIC;
                Bypass_EN_6      : OUT STD_LOGIC;
                Bypass_EN_7      : OUT STD_LOGIC;
                Hold_Ctrl_0      : OUT STD_LOGIC;
                Hold_Ctrl_1      : OUT STD_LOGIC;
                Hold_Ctrl_2      : OUT STD_LOGIC;
                Hold_Ctrl_3      : OUT STD_LOGIC;
                Hold_Ctrl_4      : OUT STD_LOGIC;
                Hold_Ctrl_5      : OUT STD_LOGIC;
                Hold_Ctrl_6      : OUT STD_LOGIC;
                Hold_Ctrl_7      : OUT STD_LOGIC;
                DFF_Ctrl_0       : OUT STD_LOGIC;
                DFF_Ctrl_1       : OUT STD_LOGIC;
                DFF_Ctrl_2       : OUT STD_LOGIC;
                DFF_Ctrl_3       : OUT STD_LOGIC;
                DFF_Ctrl_4       : OUT STD_LOGIC;
                DFF_Ctrl_5       : OUT STD_LOGIC;
                DFF_Ctrl_6       : OUT STD_LOGIC;
                DFF_Ctrl_7       : OUT STD_LOGIC;
                hold_seg_0       : OUT STD_LOGIC;
                hold_seg_1       : OUT STD_LOGIC;
                hold_seg_2       : OUT STD_LOGIC;
                hold_seg_3       : OUT STD_LOGIC;
                hold_seg_4       : OUT STD_LOGIC;
                hold_seg_5       : OUT STD_LOGIC;
                hold_seg_6       : OUT STD_LOGIC;
                hold_seg_7       : OUT STD_LOGIC;
                in_ctrl_all_cb   : OUT STD_LOGIC;
                hold_all_out     : OUT STD_LOGIC;
                in_ctrl_all_out  : OUT STD_LOGIC;
                counter_en       : OUT STD_LOGIC
			);
END master_control;

ARCHITECTURE behavioral OF master_control IS
TYPE FSMSTATE IS (
	state_0, state_1, state_2, state_3, state_4, state_5, state_6,  
	state_7, state_8, state_9, state_10, state_11, state_12, state_13, 
	state_14, state_15, state_16, state_17, state_18, state_19, state_20, 
	state_21, state_22
	);

SIGNAL currentstate	: FSMSTATE;
	BEGIN
	PROCESS(clk,rst,currentstate,mastertrig)
	BEGIN
		IF rst='1' THEN
			currentstate <= state_0;
		ELSE
			IF ((clk'EVENT) AND (clk='1'))  THEN
				CASE currentstate IS
                    WHEN state_0 		 =>
                        hold_all_in    <=  '0';
                        hold_buf_3     <=  '1';
                        hold_buf_2     <=  '1';
                        hold_buf_1     <=  '1';
                        in_ctrl_buf_3  <=  '0';
                        in_ctrl_buf_2  <=  '0';
                        in_ctrl_buf_1  <=  '0';
                        pos_hold_ctrl  <=  '0';
                        Shuf_Ctrl_1    <=  "000";
                        Shuf_Ctrl_2    <=  "000";
                        Shuf_Ctrl_3    <=  "000";
                        Shuf_Ctrl_4    <=  "000";
                        Shuf_Ctrl_5    <=  "000";
                        Shuf_Ctrl_6    <=  "000";
                        Shuf_Ctrl_7    <=  "000";
                        Shuf_Ctrl_8    <=  "000";
                        Type_Sel_1     <=  "000";
                        Type_Sel_2     <=  "000";
                        Type_Sel_3     <=  "000";
                        Type_Sel_4     <=  "000";
                        Type_Sel_5     <=  "000";
                        Type_Sel_6     <=  "000";
                        Type_Sel_7     <=  "000";
                        Type_Sel_8     <=  "000";
                        Bypass_Sel_0   <=  "000";
                        Bypass_Sel_1   <=  "000";
                        Bypass_Sel_2   <=  "000";
                        Bypass_Sel_3   <=  "000";
                        Bypass_Sel_4   <=  "000";
                        Bypass_Sel_5   <=  "000";
                        Bypass_Sel_6   <=  "000";
                        Bypass_Sel_7   <=  "000";
                        DeShuf_Ctrl_0  <=  "000";
                        DeShuf_Ctrl_1  <=  "000";
                        DeShuf_Ctrl_2  <=  "000";
                        DeShuf_Ctrl_3  <=  "000";
                        DeShuf_Ctrl_4  <=  "000";
                        DeShuf_Ctrl_5  <=  "000";
                        DeShuf_Ctrl_6  <=  "000";
                        DeShuf_Ctrl_7  <=  "000";
                        Bypass_EN_0    <=  '1';
                        Bypass_EN_1    <=  '1';
                        Bypass_EN_2    <=  '1';
                        Bypass_EN_3    <=  '1';
                        Bypass_EN_4    <=  '1';
                        Bypass_EN_5    <=  '1';
                        Bypass_EN_6    <=  '1';
                        Bypass_EN_7    <=  '1';
                        Hold_Ctrl_0    <=  '0';
                        Hold_Ctrl_1    <=  '0';
                        Hold_Ctrl_2    <=  '0';
                        Hold_Ctrl_3    <=  '0';
                        Hold_Ctrl_4    <=  '0';
                        Hold_Ctrl_5    <=  '0';
                        Hold_Ctrl_6    <=  '0';
                        Hold_Ctrl_7    <=  '0';
                        DFF_Ctrl_0     <=  '0';
                        DFF_Ctrl_1     <=  '0';
                        DFF_Ctrl_2     <=  '0';
                        DFF_Ctrl_3     <=  '0';
                        DFF_Ctrl_4     <=  '0';
                        DFF_Ctrl_5     <=  '0';
                        DFF_Ctrl_6     <=  '0';
                        DFF_Ctrl_7     <=  '0';
                        hold_seg_0     <=  '1';
                        hold_seg_1     <=  '1';
                        hold_seg_2     <=  '1';
                        hold_seg_3     <=  '1';
                        hold_seg_4     <=  '1';
                        hold_seg_5     <=  '1';
                        hold_seg_6     <=  '1';
                        hold_seg_7     <=  '1';
                        in_ctrl_all_cb <=  '1';
                        hold_all_out   <=  '0';
                        in_ctrl_all_out<=  '0';
                        counter_en     <=  '0';		
						IF mastertrig='1' THEN
							currentstate   <= state_1;
						ELSE
							currentstate   <= state_0;
						END IF;
                    WHEN state_1		 =>
                        hold_all_in    <=  '0';
                        hold_buf_3     <=  '1';
                        hold_buf_2     <=  '1';
                        hold_buf_1     <=  '1';
                        in_ctrl_buf_3  <=  '0';
                        in_ctrl_buf_2  <=  '0';
                        in_ctrl_buf_1  <=  '0';
                        pos_hold_ctrl  <=  '0';
                        Shuf_Ctrl_1    <=  "000";
                        Shuf_Ctrl_2    <=  "000";
                        Shuf_Ctrl_3    <=  "000";
                        Shuf_Ctrl_4    <=  "000";
                        Shuf_Ctrl_5    <=  "000";
                        Shuf_Ctrl_6    <=  "000";
                        Shuf_Ctrl_7    <=  "000";
                        Shuf_Ctrl_8    <=  "000";
                        Type_Sel_1     <=  "000";
                        Type_Sel_2     <=  "000";
                        Type_Sel_3     <=  "000";
                        Type_Sel_4     <=  "000";
                        Type_Sel_5     <=  "000";
                        Type_Sel_6     <=  "000";
                        Type_Sel_7     <=  "000";
                        Type_Sel_8     <=  "000";
                        Bypass_Sel_0   <=  "000";
                        Bypass_Sel_1   <=  "000";
                        Bypass_Sel_2   <=  "000";
                        Bypass_Sel_3   <=  "000";
                        Bypass_Sel_4   <=  "000";
                        Bypass_Sel_5   <=  "000";
                        Bypass_Sel_6   <=  "000";
                        Bypass_Sel_7   <=  "000";
                        DeShuf_Ctrl_0  <=  "000";
                        DeShuf_Ctrl_1  <=  "000";
                        DeShuf_Ctrl_2  <=  "000";
                        DeShuf_Ctrl_3  <=  "000";
                        DeShuf_Ctrl_4  <=  "000";
                        DeShuf_Ctrl_5  <=  "000";
                        DeShuf_Ctrl_6  <=  "000";
                        DeShuf_Ctrl_7  <=  "000";
                        Bypass_EN_0    <=  '1';
                        Bypass_EN_1    <=  '1';
                        Bypass_EN_2    <=  '1';
                        Bypass_EN_3    <=  '1';
                        Bypass_EN_4    <=  '1';
                        Bypass_EN_5    <=  '1';
                        Bypass_EN_6    <=  '1';
                        Bypass_EN_7    <=  '1';
                        Hold_Ctrl_0    <=  '0';
                        Hold_Ctrl_1    <=  '0';
                        Hold_Ctrl_2    <=  '0';
                        Hold_Ctrl_3    <=  '0';
                        Hold_Ctrl_4    <=  '0';
                        Hold_Ctrl_5    <=  '0';
                        Hold_Ctrl_6    <=  '0';
                        Hold_Ctrl_7    <=  '0';
                        DFF_Ctrl_0     <=  '0';
                        DFF_Ctrl_1     <=  '0';
                        DFF_Ctrl_2     <=  '0';
                        DFF_Ctrl_3     <=  '0';
                        DFF_Ctrl_4     <=  '0';
                        DFF_Ctrl_5     <=  '0';
                        DFF_Ctrl_6     <=  '0';
                        DFF_Ctrl_7     <=  '0';
                        hold_seg_0     <=  '0';
                        hold_seg_1     <=  '1';
                        hold_seg_2     <=  '1';
                        hold_seg_3     <=  '1';
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
                        Bypass_EN_0    <=  '0';
                        Bypass_EN_1    <=  '0';
                        Bypass_EN_2    <=  '0';
                        Bypass_EN_3    <=  '0';
                        Bypass_EN_4    <=  '0';
                        Bypass_EN_5    <=  '0';
                        Bypass_EN_6    <=  '0';
                        Bypass_EN_7    <=  '0';
                        Hold_Ctrl_0    <=  '0';
                        Hold_Ctrl_1    <=  '0';
                        Hold_Ctrl_2    <=  '0';
                        Hold_Ctrl_3    <=  '0';
                        Hold_Ctrl_4    <=  '0';
                        Hold_Ctrl_5    <=  '0';
                        Hold_Ctrl_6    <=  '0';
                        Hold_Ctrl_7    <=  '0';
                        DFF_Ctrl_0     <=  '0';
                        DFF_Ctrl_1     <=  '0';
                        DFF_Ctrl_2     <=  '0';
                        DFF_Ctrl_3     <=  '0';
                        DFF_Ctrl_4     <=  '0';
                        DFF_Ctrl_5     <=  '0';
                        DFF_Ctrl_6     <=  '0';
                        DFF_Ctrl_7     <=  '0';
                        hold_seg_0     <=  '1';
                        hold_seg_1     <=  '1';
                        hold_seg_2     <=  '1';
                        hold_seg_3     <=  '1';
                        hold_seg_4     <=  '1';
                        hold_seg_5     <=  '1';
                        hold_seg_6     <=  '1';
                        hold_seg_7     <=  '1';
                        in_ctrl_all_cb <=  '1';
                        hold_all_out   <=  '0';
                        in_ctrl_all_out<=  '0';
                        counter_en     <=  '0';
                        currentstate   <= state_0;					
				END CASE;
			ELSE
				currentstate <= currentstate;
			END IF;
		END IF;		
	END PROCESS;
END behavioral;
