hibagus/64pointFFTProcessor/VHDL/fft_8p_16b_top.vhd

LIBRARY ieee;
USE ieee.std_logic_1164.all;

ENTITY fft_8p_16b_top IS
	PORT	(
				xt0		:	IN	STD_LOGIC_VECTOR(31 DOWNTO 0);
				xt1		:	IN	STD_LOGIC_VECTOR(31 DOWNTO 0);
				xt2		:	IN	STD_LOGIC_VECTOR(31 DOWNTO 0);
				xt3		:	IN	STD_LOGIC_VECTOR(31 DOWNTO 0);
				xt4		:	IN	STD_LOGIC_VECTOR(31 DOWNTO 0);
				xt5		:	IN	STD_LOGIC_VECTOR(31 DOWNTO 0);
				xt6		:	IN	STD_LOGIC_VECTOR(31 DOWNTO 0);
				xt7		:	IN	STD_LOGIC_VECTOR(31 DOWNTO 0);
				xf0		:	OUT	STD_LOGIC_VECTOR(31 DOWNTO 0);
				xf1		:	OUT	STD_LOGIC_VECTOR(31 DOWNTO 0);
				xf2		:	OUT	STD_LOGIC_VECTOR(31 DOWNTO 0);
				xf3		:	OUT	STD_LOGIC_VECTOR(31 DOWNTO 0);
				xf4		:	OUT	STD_LOGIC_VECTOR(31 DOWNTO 0);
				xf5		:	OUT	STD_LOGIC_VECTOR(31 DOWNTO 0);
				xf6		:	OUT	STD_LOGIC_VECTOR(31 DOWNTO 0);
				xf7		:	OUT	STD_LOGIC_VECTOR(31 DOWNTO 0)
			);
END fft_8p_16b_top;

ARCHITECTURE structural of fft_8p_16b_top IS
COMPONENT complex_mult_twiddle_wn0_32b IS
	PORT	(
				A32		:	IN	STD_LOGIC_VECTOR (31 DOWNTO 0);
				R32		:	OUT STD_LOGIC_VECTOR (31 DOWNTO 0)
			);
END COMPONENT;
COMPONENT complex_mult_twiddle_wn1_32b IS
	PORT	(
				A32		:	IN	STD_LOGIC_VECTOR (31 DOWNTO 0);
				R32		:	OUT STD_LOGIC_VECTOR (31 DOWNTO 0)
			);
END COMPONENT;
COMPONENT complex_mult_twiddle_wn2_32b IS
	PORT	(
				A32		:	IN	STD_LOGIC_VECTOR (31 DOWNTO 0);
				R32		:	OUT STD_LOGIC_VECTOR (31 DOWNTO 0)
			);
END COMPONENT;
COMPONENT complex_mult_twiddle_wn3_32b IS
	PORT	(
				A32		:	IN	STD_LOGIC_VECTOR (31 DOWNTO 0);
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
				);
CSUBTR_10 :
	complex_subst_cla_32b
		PORT MAP (
					A32	=> CSUBTR_4_OUT,
					B32	=> CMULT_WN2_2_OUT,
					R32 => CSUBTR_10_OUT
				);
CSUBTR_11 :
	complex_subst_cla_32b
		PORT MAP (
					A32	=> CSUBTR_5_OUT,
					B32	=> CMULT_WN3_0_OUT,
					R32 => CSUBTR_11_OUT
				);
END structural;
