hibagus/64pointFFTProcessor/Verilog/interdimensional_multiplier.v

module interdimensional_multiplier(
  clk,
  rst,
  SET_0_IN,
  SET_1_IN,
  SET_2_IN,
  SET_3_IN,
  SET_4_IN,
  SET_5_IN,
  SET_6_IN,
  SET_7_IN,
  Shuf_Ctrl_0,
  Shuf_Ctrl_1,
  Shuf_Ctrl_2,
  Shuf_Ctrl_3,
  Shuf_Ctrl_4,
  Shuf_Ctrl_5,
  Shuf_Ctrl_6,
  Shuf_Ctrl_7,
  Type_Sel_0,
  Type_Sel_1,
  Type_Sel_2,
  Type_Sel_3,
  Type_Sel_4,
  Type_Sel_5,
  Type_Sel_6,
  Type_Sel_7,
  Bypass_Sel_0,
  Bypass_Sel_1,
  Bypass_Sel_2,
  Bypass_Sel_3,
  Bypass_Sel_4,
  Bypass_Sel_5,
  Bypass_Sel_6,
  Bypass_Sel_7,
  DeShuf_Ctrl_0,
  DeShuf_Ctrl_1,
  DeShuf_Ctrl_2,
  DeShuf_Ctrl_3,
  DeShuf_Ctrl_4,
  DeShuf_Ctrl_5,
  DeShuf_Ctrl_6,
  DeShuf_Ctrl_7,
  Bypass_EN_0,
  Bypass_EN_1,
  Bypass_EN_2,
  Bypass_EN_3,
  Bypass_EN_4,
  Bypass_EN_5,
  Bypass_EN_6,
  Bypass_EN_7,
  Hold_Ctrl_0,
  Hold_Ctrl_1,
  Hold_Ctrl_2,
  Hold_Ctrl_3,
  Hold_Ctrl_4,
  Hold_Ctrl_5,
  Hold_Ctrl_6,
  Hold_Ctrl_7,
  DFF_Ctrl_0,
  DFF_Ctrl_1,
  DFF_Ctrl_2,
  DFF_Ctrl_3,
  DFF_Ctrl_4,
  DFF_Ctrl_5,
  DFF_Ctrl_6,
  DFF_Ctrl_7,
  SET_0_OUT,
  SET_1_OUT,
  SET_2_OUT,
  SET_3_OUT,
  SET_4_OUT,
  SET_5_OUT,
  SET_6_OUT,
  SET_7_OUT
  );

  input         clk;
  input         rst;
  input [31:0]  SET_0_IN;
  input [31:0]  SET_1_IN;
  input [31:0]  SET_2_IN;
  input [31:0]  SET_3_IN;
  input [31:0]  SET_4_IN;
  input [31:0]  SET_5_IN;
  input [31:0]  SET_6_IN;
  input [31:0]  SET_7_IN;
  input [2:0]   Shuf_Ctrl_0;
  input [2:0]   Shuf_Ctrl_1;
  input [2:0]   Shuf_Ctrl_2;
  input [2:0]   Shuf_Ctrl_3;
  input [2:0]   Shuf_Ctrl_4;
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
  
  mux_2_to_1 # (
    .DATA_WIDTH(32)
  ) mux_2_to_1_insthold6 (
    .D0(MUX_BYPASS_6_OUT),
    .D1(DFF_6_OUT),
    .S(DFF_Ctrl_6),
    .Y(MUX_HOLD_6_OUT)
  ); 
  
  mux_2_to_1 # (
    .DATA_WIDTH(32)
  ) mux_2_to_1_insthold7 (
    .D0(MUX_BYPASS_7_OUT),
    .D1(DFF_7_OUT),
    .S(DFF_Ctrl_7),
    .Y(MUX_HOLD_7_OUT)
  ); 
  			
endmodule									
