hibagus/64pointFFTProcessor/VHDL/generic_mult_16b.vhd

LIBRARY ieee;
USE ieee.std_logic_1164.all;

ENTITY generic_mult_16b IS
	GENERIC (
				Const	:	STD_LOGIC_VECTOR(15 DOWNTO 0) := "0000000000000000"
			);
	PORT	(
				Data_In	:	IN	STD_LOGIC_VECTOR(15 DOWNTO 0);
				Data_Out:	OUT	STD_LOGIC_VECTOR(15 DOWNTO 0)
			);
END generic_mult_16b;

ARCHITECTURE structural of generic_mult_16b IS
COMPONENT adder_cla_32b IS
	PORT	(
				A32		:	IN	STD_LOGIC_VECTOR (31 DOWNTO 0);
				B32		:	IN	STD_LOGIC_VECTOR (31 DOWNTO 0);
				R32		:	OUT STD_LOGIC_VECTOR (31 DOWNTO 0);
				C_OUT32	:	OUT STD_LOGIC
			);
END COMPONENT;
COMPONENT sgninv_16b IS
	PORT	(
				A16		:	IN	STD_LOGIC_VECTOR (15 DOWNTO 0);
				R16		:	OUT STD_LOGIC_VECTOR (15 DOWNTO 0);
				C_OUT16 :	OUT STD_LOGIC
			);
END COMPONENT;
COMPONENT bit_adj_32b_to_16b IS
	PORT 	(
				Data_In	:	IN	std_logic_vector (31 DOWNTO 0);
				Data_Out:	OUT	std_logic_vector (15 DOWNTO 0)
			);
END COMPONENT;
COMPONENT mux_2to1_16b IS
	PORT 	(
				D1	:	IN	std_logic_vector (15 DOWNTO 0);
				D2	:	IN	std_logic_vector (15 DOWNTO 0);
				Y	:	OUT	std_logic_vector (15 DOWNTO 0);
				S	:	IN	std_logic
			);
END COMPONENT;
COMPONENT lshift_0_16b_to_32b IS
	PORT 	(
				Data_In	:	IN	std_logic_vector (15 DOWNTO 0);
				Data_Out:	OUT	std_logic_vector (31 DOWNTO 0)
			);
END COMPONENT;
COMPONENT lshift_1_16b_to_32b IS
	PORT 	(
				Data_In	:	IN	std_logic_vector (15 DOWNTO 0);
				Data_Out:	OUT	std_logic_vector (31 DOWNTO 0)
			);
END COMPONENT;
COMPONENT lshift_2_16b_to_32b IS
	PORT 	(
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
						 (Const(4)='1' or Const(5)='1' or Const(6)='1' or Const(7)='1') ) GENERATE
					BEGIN
						adder_12_out	<= adder_9_out;
					END GENERATE adder_12_RIGHT;
					
	adder_13_BOTH: IF (	(Const(8)='1' or Const(9)='1' or Const(10)='1' or Const(11)='1') and 
						(Const(12)='1' or Const(13)='1' or Const(14)='1' or Const(15)='1') ) GENERATE
					BEGIN
						adder_13		:
							adder_cla_32b
							PORT MAP (
										A32	=>	adder_10_out,
										B32	=>	adder_11_out,
										R32	=>	adder_13_out
									);
					END GENERATE adder_13_BOTH;
	adder_13_LEFT: IF (	(Const(8)='1' or Const(9)='1' or Const(10)='1' or Const(11)='1') and 
						(Const(12)='0' and Const(13)='0' and Const(14)='0' and Const(15)='0') ) GENERATE
					BEGIN
						adder_13_out	<= adder_10_out;
					END GENERATE adder_13_LEFT;
	adder_13_RIGHT: IF ( (Const(8)='0' and Const(9)='0' and Const(10)='0' and Const(11)='0') and 
						 (Const(12)='1' or Const(13)='1' or Const(14)='1' or Const(15)='1') ) GENERATE
					BEGIN
						adder_13_out	<= adder_11_out;
					END GENERATE adder_13_RIGHT;			
	adder_14_BOTH: IF (	(Const(0)='1' or Const(1)='1' or Const(2)='1' or Const(3)='1' or
						 Const(4)='1' or Const(5)='1' or Const(6)='1' or Const(7)='1') and 
						(Const(8)='1' or Const(9)='1' or Const(10)='1' or Const(11)='1' or
						 Const(12)='1' or Const(13)='1' or Const(14)='1' or Const(15)='1')) GENERATE
					BEGIN
						adder_14		:
							adder_cla_32b
							PORT MAP (
										A32	=>	adder_12_out,
										B32	=>	adder_13_out,
										R32	=>	adder_14_out
									);
					END GENERATE adder_14_BOTH;
	adder_14_LEFT: IF (	(Const(0)='1' or Const(1)='1' or Const(2)='1' or Const(3)='1' or
						 Const(4)='1' or Const(5)='1' or Const(6)='1' or Const(7)='1') and 
						(Const(8)='0' and Const(9)='0' and Const(10)='0' and Const(11)='0' and
						 Const(12)='0' and Const(13)='0' and Const(14)='0' and Const(15)='0')) GENERATE
					BEGIN
						adder_14_out	<= adder_12_out;
					END GENERATE adder_14_LEFT;
	adder_14_RIGHT: IF ((Const(0)='0' and Const(1)='0' and Const(2)='0' and Const(3)='0' and
						 Const(4)='0' and Const(5)='0' and Const(6)='0' and Const(7)='0') and 
						(Const(8)='1' or Const(9)='1' or Const(10)='1' or Const(11)='1' or
						 Const(12)='1' or Const(13)='1' or Const(14)='1' or Const(15)='1')) GENERATE
					BEGIN
						adder_14_out	<= adder_13_out;
					END GENERATE adder_14_RIGHT;
	
	adder_NONE: 	IF ((Const(0)='0' and Const(1)='0' and Const(2)='0' and Const(3)='0' and
						 Const(4)='0' and Const(5)='0' and Const(6)='0' and Const(7)='0') and 
						(Const(8)='0' and Const(9)='0' and Const(10)='0' and Const(11)='0' and
						 Const(12)='0' and Const(13)='0' and Const(14)='0' and Const(15)='0')) GENERATE
					BEGIN
						adder_14_out	<= "00000000000000000000000000000000";
					END GENERATE adder_NONE;
	bitadj		:
		bit_adj_32b_to_16b
			PORT MAP (
						Data_In		=>	adder_14_out,
						Data_Out	=>	bitadj_out
					);	
	sgninv_1	:
		sgninv_16b
			PORT MAP (
						A16	=>	bitadj_out,
						R16 =>	sgninv_1_out
					);
	mux_1		:
		mux_2to1_16b
			PORT MAP (
						D1	=>	bitadj_out,
						D2	=>	sgninv_1_out,
						Y	=>	mux_1_out,
						S	=>	Data_In(15)
					);
END structural;
