hibagus/64pointFFTProcessor/VHDL/interdimensional_multiplier.vhd

LIBRARY ieee;
USE ieee.std_logic_1164.all;

ENTITY interdimensional_multiplier IS
	PORT	(
				clk				:	IN	STD_LOGIC;
				rst				:	IN  STD_LOGIC;
				SET_0_IN		:	IN	STD_LOGIC_VECTOR (31 DOWNTO 0);
				SET_1_IN		:	IN	STD_LOGIC_VECTOR (31 DOWNTO 0);
				SET_2_IN		:	IN	STD_LOGIC_VECTOR (31 DOWNTO 0);
				SET_3_IN		:	IN	STD_LOGIC_VECTOR (31 DOWNTO 0);
				SET_4_IN		:	IN	STD_LOGIC_VECTOR (31 DOWNTO 0);
				SET_5_IN		:	IN	STD_LOGIC_VECTOR (31 DOWNTO 0);
				SET_6_IN		:	IN	STD_LOGIC_VECTOR (31 DOWNTO 0);
				SET_7_IN		:	IN	STD_LOGIC_VECTOR (31 DOWNTO 0);
				Shuf_Ctrl_1		:	IN  STD_LOGIC_VECTOR (2 DOWNTO 0);
				Shuf_Ctrl_2		:	IN  STD_LOGIC_VECTOR (2 DOWNTO 0);
				Shuf_Ctrl_3		:	IN  STD_LOGIC_VECTOR (2 DOWNTO 0);
				Shuf_Ctrl_4		:	IN  STD_LOGIC_VECTOR (2 DOWNTO 0);
				Shuf_Ctrl_5		:	IN  STD_LOGIC_VECTOR (2 DOWNTO 0);
				Shuf_Ctrl_6		:	IN  STD_LOGIC_VECTOR (2 DOWNTO 0);
				Shuf_Ctrl_7		:	IN  STD_LOGIC_VECTOR (2 DOWNTO 0);
				Shuf_Ctrl_8		:	IN  STD_LOGIC_VECTOR (2 DOWNTO 0);
				Type_Sel_1		:	IN  STD_LOGIC_VECTOR (2 DOWNTO 0);
				Type_Sel_2		:	IN  STD_LOGIC_VECTOR (2 DOWNTO 0);
				Type_Sel_3		:	IN  STD_LOGIC_VECTOR (2 DOWNTO 0);
				Type_Sel_4		:	IN  STD_LOGIC_VECTOR (2 DOWNTO 0);
				Type_Sel_5		:	IN  STD_LOGIC_VECTOR (2 DOWNTO 0);
				Type_Sel_6		:	IN  STD_LOGIC_VECTOR (2 DOWNTO 0);
				Type_Sel_7		:	IN  STD_LOGIC_VECTOR (2 DOWNTO 0);
				Type_Sel_8		:	IN  STD_LOGIC_VECTOR (2 DOWNTO 0);
				Bypass_Sel_0	:	IN	STD_LOGIC_VECTOR (2 DOWNTO 0);
				Bypass_Sel_1	:	IN	STD_LOGIC_VECTOR (2 DOWNTO 0);
				Bypass_Sel_2	:	IN	STD_LOGIC_VECTOR (2 DOWNTO 0);
				Bypass_Sel_3	:	IN	STD_LOGIC_VECTOR (2 DOWNTO 0);
				Bypass_Sel_4	:	IN	STD_LOGIC_VECTOR (2 DOWNTO 0);
				Bypass_Sel_5	:	IN	STD_LOGIC_VECTOR (2 DOWNTO 0);
				Bypass_Sel_6	:	IN	STD_LOGIC_VECTOR (2 DOWNTO 0);
				Bypass_Sel_7	:	IN	STD_LOGIC_VECTOR (2 DOWNTO 0);
				DeShuf_Ctrl_0	:	IN  STD_LOGIC_VECTOR (2 DOWNTO 0);
				DeShuf_Ctrl_1	:	IN  STD_LOGIC_VECTOR (2 DOWNTO 0);
				DeShuf_Ctrl_2	:	IN  STD_LOGIC_VECTOR (2 DOWNTO 0);
				DeShuf_Ctrl_3	:	IN  STD_LOGIC_VECTOR (2 DOWNTO 0);
				DeShuf_Ctrl_4	:	IN  STD_LOGIC_VECTOR (2 DOWNTO 0);
				DeShuf_Ctrl_5	:	IN  STD_LOGIC_VECTOR (2 DOWNTO 0);
				DeShuf_Ctrl_6	:	IN  STD_LOGIC_VECTOR (2 DOWNTO 0);
				DeShuf_Ctrl_7	:	IN  STD_LOGIC_VECTOR (2 DOWNTO 0);
				Bypass_EN_0		:	IN 	STD_LOGIC;
				Bypass_EN_1		:	IN 	STD_LOGIC;
				Bypass_EN_2		:	IN 	STD_LOGIC;
				Bypass_EN_3		:	IN 	STD_LOGIC;
				Bypass_EN_4		:	IN 	STD_LOGIC;
				Bypass_EN_5		:	IN 	STD_LOGIC;
				Bypass_EN_6		:	IN 	STD_LOGIC;
				Bypass_EN_7		:	IN 	STD_LOGIC;
				Hold_Ctrl_0		:	IN  STD_LOGIC;
				Hold_Ctrl_1		:	IN  STD_LOGIC;
				Hold_Ctrl_2		:	IN  STD_LOGIC;
				Hold_Ctrl_3		:	IN  STD_LOGIC;
				Hold_Ctrl_4		:	IN  STD_LOGIC;
				Hold_Ctrl_5		:	IN  STD_LOGIC;
				Hold_Ctrl_6		:	IN  STD_LOGIC;
				Hold_Ctrl_7		:	IN  STD_LOGIC;
				DFF_Ctrl_0		:	IN  STD_LOGIC;
				DFF_Ctrl_1		:	IN  STD_LOGIC;
				DFF_Ctrl_2		:	IN  STD_LOGIC;
				DFF_Ctrl_3		:	IN  STD_LOGIC;
				DFF_Ctrl_4		:	IN  STD_LOGIC;
				DFF_Ctrl_5		:	IN  STD_LOGIC;
				DFF_Ctrl_6		:	IN  STD_LOGIC;
				DFF_Ctrl_7		:	IN  STD_LOGIC;
				SET_0_OUT		:	OUT	STD_LOGIC_VECTOR (31 DOWNTO 0);
				SET_1_OUT		:	OUT	STD_LOGIC_VECTOR (31 DOWNTO 0);
				SET_2_OUT		:	OUT	STD_LOGIC_VECTOR (31 DOWNTO 0);
				SET_3_OUT		:	OUT	STD_LOGIC_VECTOR (31 DOWNTO 0);
				SET_4_OUT		:	OUT	STD_LOGIC_VECTOR (31 DOWNTO 0);
				SET_5_OUT		:	OUT	STD_LOGIC_VECTOR (31 DOWNTO 0);
				SET_6_OUT		:	OUT	STD_LOGIC_VECTOR (31 DOWNTO 0);
				SET_7_OUT		:	OUT	STD_LOGIC_VECTOR (31 DOWNTO 0)
			);
END interdimensional_multiplier;

ARCHITECTURE structural OF interdimensional_multiplier IS
COMPONENT generic_complex_mult_block IS
	GENERIC (
				C_PLUS_S:	STD_LOGIC_VECTOR (15 DOWNTO 0) := "0000000000000000";
				C_ONLY  :   STD_LOGIC_VECTOR (15 DOWNTO 0) := "0000000000000000";
				C_MIN_S :	STD_LOGIC_VECTOR (15 DOWNTO 0) := "0000000000000000"
				
			);
	PORT	(
				A32		:	IN	STD_LOGIC_VECTOR (31 DOWNTO 0);
				TYPESEL :	IN	STD_LOGIC_VECTOR (2 DOWNTO 0);
				R32		:	OUT STD_LOGIC_VECTOR (31 DOWNTO 0)
			);
END COMPONENT;
COMPONENT bypass_32b IS
	PORT	(
				A32		:	IN	STD_LOGIC_VECTOR (31 DOWNTO 0);
				TYPESEL :	IN	STD_LOGIC_VECTOR (2 DOWNTO 0);
				R32		:	OUT STD_LOGIC_VECTOR (31 DOWNTO 0)
			);
END COMPONENT;
COMPONENT mux_2to1_32b IS
	PORT 	(
				D1	:	IN	std_logic_vector (31 DOWNTO 0);
				D2	:	IN	std_logic_vector (31 DOWNTO 0);
				Y	:	OUT	std_logic_vector (31 DOWNTO 0);
				S	:	IN	std_logic
			);
END COMPONENT;
COMPONENT mux_8to1_32b IS
	PORT 	(
				D1	:	IN	std_logic_vector (31 DOWNTO 0);
				D2	:	IN	std_logic_vector (31 DOWNTO 0);
				D3	:	IN	std_logic_vector (31 DOWNTO 0);
				D4	:	IN	std_logic_vector (31 DOWNTO 0);
				D5	:	IN	std_logic_vector (31 DOWNTO 0);
				D6	:	IN	std_logic_vector (31 DOWNTO 0);
				D7	:	IN	std_logic_vector (31 DOWNTO 0);
				D8	:	IN	std_logic_vector (31 DOWNTO 0);
				Y	:	OUT	std_logic_vector (31 DOWNTO 0);
				S	:	IN	std_logic_vector (2 DOWNTO 0)
			);
END COMPONENT;
COMPONENT dff_with_hold_32b IS
	PORT 	(
				D		:	IN		STD_LOGIC_VECTOR (31 DOWNTO 0);
				clk		:	IN		STD_LOGIC;
				hold	:	IN		STD_LOGIC;
				rst		:	IN 		STD_LOGIC;
				Q		:	OUT 	STD_LOGIC_VECTOR (31 DOWNTO 0)
			);
END COMPONENT;

SIGNAL MUX_SHUFFLE_1_OUT	: STD_LOGIC_VECTOR(31 DOWNTO 0);
SIGNAL MUX_SHUFFLE_2_OUT	: STD_LOGIC_VECTOR(31 DOWNTO 0);
SIGNAL MUX_SHUFFLE_3_OUT	: STD_LOGIC_VECTOR(31 DOWNTO 0);
SIGNAL MUX_SHUFFLE_4_OUT	: STD_LOGIC_VECTOR(31 DOWNTO 0);
SIGNAL MUX_SHUFFLE_5_OUT	: STD_LOGIC_VECTOR(31 DOWNTO 0);
SIGNAL MUX_SHUFFLE_6_OUT	: STD_LOGIC_VECTOR(31 DOWNTO 0);
SIGNAL MUX_SHUFFLE_7_OUT	: STD_LOGIC_VECTOR(31 DOWNTO 0);
SIGNAL MUX_SHUFFLE_8_OUT	: STD_LOGIC_VECTOR(31 DOWNTO 0);
SIGNAL BLOCK_MULT_1_OUT		: STD_LOGIC_VECTOR(31 DOWNTO 0);
SIGNAL BLOCK_MULT_2_OUT		: STD_LOGIC_VECTOR(31 DOWNTO 0);
SIGNAL BLOCK_MULT_3_OUT		: STD_LOGIC_VECTOR(31 DOWNTO 0);
SIGNAL BLOCK_MULT_4_OUT		: STD_LOGIC_VECTOR(31 DOWNTO 0);
SIGNAL BLOCK_MULT_5_OUT		: STD_LOGIC_VECTOR(31 DOWNTO 0);
SIGNAL BLOCK_MULT_6_OUT		: STD_LOGIC_VECTOR(31 DOWNTO 0);
SIGNAL BLOCK_MULT_7_OUT		: STD_LOGIC_VECTOR(31 DOWNTO 0);
SIGNAL BLOCK_MULT_8_OUT		: STD_LOGIC_VECTOR(31 DOWNTO 0);
SIGNAL BLOCK_BYPASS_0_OUT	: STD_LOGIC_VECTOR(31 DOWNTO 0);
SIGNAL BLOCK_BYPASS_1_OUT	: STD_LOGIC_VECTOR(31 DOWNTO 0);
SIGNAL BLOCK_BYPASS_2_OUT	: STD_LOGIC_VECTOR(31 DOWNTO 0);
SIGNAL BLOCK_BYPASS_3_OUT	: STD_LOGIC_VECTOR(31 DOWNTO 0);
SIGNAL BLOCK_BYPASS_4_OUT	: STD_LOGIC_VECTOR(31 DOWNTO 0);
SIGNAL BLOCK_BYPASS_5_OUT	: STD_LOGIC_VECTOR(31 DOWNTO 0);
SIGNAL BLOCK_BYPASS_6_OUT	: STD_LOGIC_VECTOR(31 DOWNTO 0);
SIGNAL BLOCK_BYPASS_7_OUT	: STD_LOGIC_VECTOR(31 DOWNTO 0);
SIGNAL MUX_DESHUFFLE_0_OUT	: STD_LOGIC_VECTOR(31 DOWNTO 0);
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
				);
	MUX_HOLD_0 :
		mux_2to1_32b
			PORT MAP
				(
					D1	=>MUX_BYPASS_0_OUT,
					D2	=>DFF_0_OUT,
					Y	=>MUX_HOLD_0_OUT,
					S	=>DFF_Ctrl_0	
				);			
	MUX_HOLD_1 :
		mux_2to1_32b
			PORT MAP
				(
					D1	=>MUX_BYPASS_1_OUT,
					D2	=>DFF_1_OUT,
					Y	=>MUX_HOLD_1_OUT,
					S	=>DFF_Ctrl_1	
				);							
	MUX_HOLD_2 :
		mux_2to1_32b
			PORT MAP
				(
					D1	=>MUX_BYPASS_2_OUT,
					D2	=>DFF_2_OUT,
					Y	=>MUX_HOLD_2_OUT,
					S	=>DFF_Ctrl_2	
				);							
	MUX_HOLD_3 :
		mux_2to1_32b
			PORT MAP
				(
					D1	=>MUX_BYPASS_3_OUT,
					D2	=>DFF_3_OUT,
					Y	=>MUX_HOLD_3_OUT,
					S	=>DFF_Ctrl_3	
				);
	MUX_HOLD_4 :
		mux_2to1_32b
			PORT MAP
				(
					D1	=>MUX_BYPASS_4_OUT,
					D2	=>DFF_4_OUT,
					Y	=>MUX_HOLD_4_OUT,
					S	=>DFF_Ctrl_4	
				);							
	MUX_HOLD_5 :
		mux_2to1_32b
			PORT MAP
				(
					D1	=>MUX_BYPASS_5_OUT,
					D2	=>DFF_5_OUT,
					Y	=>MUX_HOLD_5_OUT,
					S	=>DFF_Ctrl_5	
				);			
	MUX_HOLD_6 :
		mux_2to1_32b
			PORT MAP
				(
					D1	=>MUX_BYPASS_6_OUT,
					D2	=>DFF_6_OUT,
					Y	=>MUX_HOLD_6_OUT,
					S	=>DFF_Ctrl_6	
				);			
	MUX_HOLD_7 :
		mux_2to1_32b
			PORT MAP
				(
					D1	=>MUX_BYPASS_7_OUT,
					D2	=>DFF_7_OUT,
					Y	=>MUX_HOLD_7_OUT,
					S	=>DFF_Ctrl_7	
				);											
																			
END structural;
