hibagus/64pointFFTProcessor/Verilog/cb_circuit.v

module cb_circuit(
  clk,
  rst,
  in_ctrl_all_seg,
  hold_seg_0,
  hold_seg_1,
  hold_seg_2,
  hold_seg_3,
  hold_seg_4,
  hold_seg_5,
  hold_seg_6,
  hold_seg_7,
  D0,
  D1,
  D2,
  D3,
  D4,
  D5,
  D6,
  D7,
  Q0,
  Q1,
  Q2,
  Q3,
  Q4,
  Q5,
  Q6,
  Q7
  );
   
  input  clk;
  input  rst;
  input  in_ctrl_all_seg;
  input  hold_seg_0;
  input  hold_seg_1;
  input  hold_seg_2;
  input  hold_seg_3;
  input  hold_seg_4;
  input  hold_seg_5;
  input  hold_seg_6;
  input  hold_seg_7;
  input  [31:0] D0;
  input  [31:0] D1;
  input  [31:0] D2;
  input  [31:0] D3;
  input  [31:0] D4;
  input  [31:0] D5;
  input  [31:0] D6;
  input  [31:0] D7;
  output [31:0] Q0;
  output [31:0] Q1;
  output [31:0] Q2;
  output [31:0] Q3;
  output [31:0] Q4;
  output [31:0] Q5;
  output [31:0] Q6;
  output [31:0] Q7;
  
  wire   clk;
  wire   rst;
  wire   in_ctrl_all_seg;
  wire   hold_seg_0;
  wire   hold_seg_1;
  wire   hold_seg_2;
  wire   hold_seg_3;
  wire   hold_seg_4;
  wire   hold_seg_5;
  wire   hold_seg_6;
  wire   hold_seg_7;
  wire   [31:0] D0;
  wire   [31:0] D1;
  wire   [31:0] D2;
  wire   [31:0] D3;
  wire   [31:0] D4;
  wire   [31:0] D5;
  wire   [31:0] D6;
  wire   [31:0] D7;
  wire   [31:0] Q0;
  wire   [31:0] Q1;
  wire   [31:0] Q2;
  wire   [31:0] Q3;
  wire   [31:0] Q4;
  wire   [31:0] Q5;
  wire   [31:0] Q6;
  wire   [31:0] Q7;

  wire   [31:0] segment_0_out;
  wire   [31:0] segment_1_out;
  wire   [31:0] segment_2_out;
  wire   [31:0] segment_3_out;
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
  ) dff_segment_for_cb_inst0 (
    .clk(clk), 
    .rst(rst), 
    .hold(hold_seg_0), 
    .sel(in_ctrl_all_seg),
    .D0(segment_1_out), 
    .D1(D0),
    .D2(D1),
    .D3(D2),
    .D4(D3),
    .D5(D4),
    .D6(D5),
    .D7(D6),
    .D8(D7),
    .Q(segment_0_out)
  );
  
endmodule
