hibagus/64pointFFTProcessor/(commit log)

2019-12-02 bypass_32b, input_counter, output_counter, interdime_mult, output_circuit, real_imaginary_interchange, rshift, scalling_oout, sgninv, subt_ksa_16b compiled & typos corrected
    [input_counter.v, interdimensional_multiplier.v, output_counter.v, scalling_out.v]
2019-12-03 Added input circuit
2019-12-03 fix the mux instantiation
    [bypass_32b.v]
2019-12-04 Reformatting Text, Fixing the lshifter instantiation
    [const_mult_ksa_16b_halfsqrt2.v]
2019-12-04 Fixing the numbering error, reformatting text, and fixing modules name
    [input_circuit.v]
2019-12-04 Fixing state machine instantiation
    [input_counter.v]
2019-12-05 fixing the miss concatenation of real and imaginary part
    [complex_mult_twiddle_wn1_32b.v]
2019-12-06 fixing the bypass input
    [interdimensional_multiplier.v]
2019-12-06 fixing output buffer hold and input control from state 13 and beyond
    [master_control.v]
2019-12-06 fixing when to enable output counter in state 13 and state 14
    [master_control.v]
2019-12-06 fixing the starting time of the timer
    [output_counter.v]
2019-12-06 fixing the starting time of the timer, fixing when the master should be triggered
    [input_counter.v]
2019-12-06 fixing when to enable the output counter
    [master_control.v]
2019-12-07 Modify the output counter to now controlling the behavior of output circuit
2019-12-07 fixing net with multiple driver issues
    [ks_6_32b.v]
2019-12-07 change the default behavior for input circuit
2019-12-07 localparam invalid bitlength fix
    [output_counter.v]
2019-12-07 fixing prepare state counter initial value
    [output_counter.v]
2019-12-07 fixing in_ctrl_all_out that should be switched to 0 on counter==7
    [output_counter.v]
2019-12-07 fixing in_ctrl_all_out that should be switched to 0 on counter==6
    [output_counter.v]
2019-12-07 remove the output circuit control from master control
2019-12-07 Revert "removed unused file"
    This reverts commit 4c2a778f671bd1648c652acef88fbabfa5d7c3df.
    [black_cell.v, ks_1_16b.v, ks_1_32b.v, ks_2_16b.v, ks_2_32b.v, ks_3_16b.v, ks_3_32b.v]
2019-12-07 add next_data to indicate whether the circuit is ready for next data thus data start can be asserted correctly
    [fft_64p_16b_top.v, fft_64p_16b_top_testbench.v, input_counter.v, master_control.v]
2019-12-07 fixed when the output circuit should latch the output data from 2nd stage FFT
    [master_control.vhd]
2019-12-08 fixing unknown net type
    [ks_1_32b.v]
2019-12-09 forget to add the clock and reset to intermediate circuit
    [fft_64p_16b_top.v]
